worktechlabs/OpenPrinter/docs/inventario.md

# Inventario disponible (material reutilizado)

Material de impresoras 3D que ya hay en el taller y su uso previsto. Las listas
de compra lo cuentan a 0 €.

| Material | Cantidad | Uso en OpenDTF |
|---|---|---|
| BTT SKR Mini E3 V3.0 (STM32G0B1, 4 × TMC2209) | 1 | Placa de control con Klipper: motores X e Y, y dos drivers libres |
| Raspberry Pi 3 | 1 | Host de Klipper e interfaz web |
| Motor NEMA17 de 40 mm (Creality 42-40, Golden Motor 42HD4041-01) | varios | Motores X e Y; al Creality hay que quitarle el extrusor |
| Fuente de 24 V de impresora 3D | 1 | Fuente principal: motores, placa y ventiladores de 24 V |
| Fuente de 12 V | 1 | Reserva (ventiladores de 12 V si salen más baratos) |
| Perfil V-slot 2020 | por medir | Estructura de la cubierta (fase 6) |
| Kit de escuadras 2020 con tuercas | 10 juegos | Uniones de perfiles 2020 |
| Rodamientos 608ZZ (8 × 22 × 7) | ~20 | Poleas locas y apoyos del eje de levante (Ø8) |
| Ventiladores 4010 de 12 V | 6 | Refrigeración de la electrónica |
| Ruedas en V (POM) | por contar | Reserva: el carro va con guías MGN12 (más precisas) |
| Correas GT2 de 6 mm y poleas de 20 dientes | varias | Eje Y (correa cerrada aparte) y X en la fase 1 |

## Pendiente de confirmar

- Longitud de cada perfil 2020 y número de ruedas en V y tuercas excéntricas.
- Potencia de la fuente de 24 V (mirar la etiqueta): con 200 W o más sobra para
  la fase 1.
