worktechlabs/OpenPrinter/docs/fase1_movimiento.md

# Fase 1: movimiento

Objetivo: que la máquina se mueva como una impresora de verdad, todavía sin
cabezal. El carro barre el film a velocidad constante con su posición leída por
un encoder lineal, y el film avanza pasos precisos medidos por un encoder en el
rodillo.

**Hito**: 1000 pasadas seguidas a 0,6 m/s con el rizado de velocidad medido y
avances de film con error por debajo del 0,05 %, registrados desde la Raspberry Pi.

## Arquitectura

```mermaid
flowchart LR
    PI["Raspberry Pi 3+<br/>interfaz, cola de trabajos,<br/>Klipper (host), RIP"]
    CTRL["Placa de control<br/>BTT SKR Mini E3 V3.0 + Klipper"]
    MON["Monitor de encoder<br/>Raspberry Pi Pico (RP2040)"]
    HEAD["Placa de disparo del cabezal<br/>(fase 3)"]

    PI -- USB --> CTRL
    PI -- USB --> MON
    CTRL --> MX[Motor X]
    CTRL --> MY[Motor Y]
    PI -- GPIO --> PUMP["5 bombas de tinta<br/>módulo MOSFET"]
    FLOAT[5 flotadores de los subdepósitos] -- GPIO --> PI
    PI -- HDMI + USB --> LCD[Pantalla táctil de 7 pulgadas]
    CTRL --> FAN[4 ventiladores de vacío]
    HOME[Final de carrera X] --> CTRL
    PINCH[Interruptor de palanca de presión] --> CTRL
    FILMS[Sensor de film] --> CTRL
    ENCY["Encoder Y AS5047P<br/>en el rodillo"] -- SPI --> MON
    ENCX["Encoder X<br/>cinta 180 LPI + sensor óptico"] --> MON
    ENCX -.-> HEAD
    PI -. datos de pasada .-> HEAD
```

La idea clave es **separar el movimiento del disparo**:

- **Klipper** mueve los motores. Está probado, tiene *input shaping* y se
  configura con un archivo de texto. No necesita saber nada del cabezal.
- **El encoder X manda.** El cabezal no dispara según los pasos del motor, sino
  según la posición real que lee el encoder. Así, las irregularidades del motor
  o de la correa no se ven en la impresión.
- En la fase 1, el encoder X lo lee un **Raspberry Pi Pico** (con su PIO cuenta
  la cuadratura sin perder pulsos). Registra la posición y la velocidad de cada
  pasada para medir la calidad del movimiento. En la fase 3 ese mismo
  microcontrolador (o una FPGA) es la base de la placa de disparo.

## Componentes

**Se reutiliza material de impresora 3D.** La fase 1 está pensada para montarse
con lo que suele haber en un taller con impresoras 3D:

- **Raspberry Pi 3**: suficiente para Klipper y la interfaz web. Solo cuando
  llegue el RIP (fase 2) puede hacer falta una Pi 4 o 5 para procesar imágenes
  grandes.
- **Cualquier placa de impresora 3D compatible con Klipper** (SKR, MKS, Creality,
  Octopus…) con al menos 2 drivers: X e Y. Si no tiene 4 salidas de
  ventilador libres, los ventiladores de vacío se gobiernan con un módulo de
  MOSFET desde pines libres.
- **Motores NEMA17, correas y poleas GT2** de impresora 3D. La correa X está
  dibujada de 10 mm, pero una GT2 de 6 mm de fibra de vidrio vale para la fase 1;
  si a 0,6 m/s se nota elasticidad en las inversiones, se cambia por una de 9 o
  10 mm.

| Bloque | Elección | Por qué |
|---|---|---|
| Host | Raspberry Pi 3 o superior | Klipper, interfaz web y, más adelante, el RIP |
| Placa de control | BTT SKR Mini E3 V3.0 con Klipper (del inventario) | 4 drivers TMC2209: X, Y y dos libres; si más adelante faltan salidas, una Octopus da 8 drivers |
| Drivers | TMC2209 en UART, 24 V | Silenciosos y con corriente configurable; si el eje X se queda corto, TMC5160 |
| Motor X | NEMA17 de 40 mm (del inventario) | Ver cálculo abajo; uno de 48 mm da más margen |
| Motor Y | NEMA17 de 40 mm (del inventario) | Con la reducción 4:1 le sobra par |
| Pantalla | Táctil de 7" HDMI + USB con KlipperScreen | Mover ejes, cargar film, limpiar, rellenar tinta y lanzar trabajos sin ordenador |
| Tinta | 5 bombas peristálticas de 12 V y 5 subdepósitos con flotador | Relleno automático desde botellas de 1 L; GPIO de la Raspberry Pi como segunda MCU de Klipper |
| Encoder X | Cinta de 180 LPI + sensor óptico de cuadratura (tipo H9730) | Estándar en impresoras de inyección; se pueden sacar de impresoras rotas |
| Encoder Y | AS5047P magnético en el extremo del eje del rodillo | 14 bits: 5,8 µm de film por cuenta; lo lee el Pico por SPI |
| Final de carrera X | Sensor óptico de horquilla + bandera en el carro | Sin contacto y repetible; marca el *home* junto a la estación de servicio |
| Sensor de film | Reflexivo (TCRT5000) bajo la mesa de entrada | Detecta fin de rollo |
| Palanca de presión | Microinterruptor | Impide mover el eje Y con las ruedas levantadas |
| Alimentación | Fuente de 24 V de impresora 3D (del inventario) | Motores, ventiladores de 24 V y placa; con 200 W o más basta |
| 5 V | Convertidor 24 → 5 V de 5 A | Raspberry Pi y Pico |
| Seguridad | Seta de emergencia NC que corta los 24 V de los motores | Para el carro al instante |

## Números que justifican el diseño

**Velocidad del carro.** Un XP600 dispara a unos 8 kHz (dato a confirmar en la
fase 3). Con pasadas de 360 ppp, la velocidad máxima útil es
8000 / 360 = 22 pulgadas/s ≈ **0,56 m/s**. El objetivo es 0,6 m/s.

**Aceleración y margen.** A 10 m/s², alcanzar 0,6 m/s necesita
v² / 2a = **18 mm**. La zona de aceleración del modelo es de 60 mm a cada lado,
así que hay margen para acelerar más suave o subir la velocidad.

**Motor X.** El carro con cabezales, dampers y tinta pesa unos 1,2 kg. Para
acelerar a 10 m/s² hacen falta 12 N; con la polea de 20 dientes (radio
6,4 mm) son 0,08 N·m. A 0,6 m/s la polea gira a 900 rpm. Un NEMA17 de 40 mm
a 24 V da unos 0,12–0,15 N·m a esas vueltas: margen de 1,5 a 1,9 veces, justo
pero suficiente. Si en las pruebas pierde pasos, se baja la aceleración a
6 m/s² (necesita 30 mm de los 60 de margen) o se cambia por uno de 48 mm.

**Resolución X.** 180 líneas por pulgada con decodificación ×4 dan
720 cuentas por pulgada: **35 µm por cuenta**. La placa de disparo interpola
entre cuentas para colocar gotas a 720 ppp o más.

**Resolución Y.** Con la reducción 4:1 y el rodillo de Ø30, el motor avanza
23,6 mm por vuelta: 7,4 µm por micropaso a 1/16. El AS5047P mide 5,8 µm por
cuenta en el rodillo, que es lo que de verdad importa: la referencia es el
rodillo, no el motor.

## Señales en la placa de control

La configuración de Klipper que usa estas señales está en
[firmware/](../firmware/README.md).

Necesidades mínimas: 2 drivers, 3 entradas digitales y salidas para los
ventiladores. La placa elegida es la **BTT SKR Mini E3 V3.0** del
inventario (ver [inventario.md](inventario.md)): 4 drivers TMC2209 en UART, y
las salidas de calentador sirven como interruptores de 24 V para los
ventiladores de vacío.

| Señal | Tipo | Conector SKR Mini E3 V3.0 |
|---|---|---|
| Motor X | paso/dirección + UART | X |
| Motor Y | paso/dirección + UART | Y |
| (libre) | paso/dirección + UART | Z |
| (libre: circulación del blanco, fase 4) | paso/dirección + UART | E |
| Final de carrera X | entrada digital | X-STOP |
| Interruptor de palanca de presión | entrada digital | Y-STOP |
| Sensor de film | entrada digital | E0-STOP (la entrada de fin de filamento) |
| Ventiladores de vacío centrales (2) | 24 V conmutado | HE0 |
| Ventiladores de vacío laterales (2) | 24 V conmutado | HB |
| Ventilador de la electrónica | PWM | FAN0 |

- Los ventiladores de vacío van en dos grupos: los dos centrales se encienden
  con cualquier ancho de film y los dos laterales solo con film de 60 cm.
- **El encoder Y (AS5047P) va al Raspberry Pi Pico por SPI**, junto con el
  encoder X: así todas las medidas de posición están en el mismo
  microcontrolador y la SKR no necesita SPI libre.
- Los ventiladores 4010 del inventario son de 12 V. Para enfriar la
  electrónica, aliméntalos desde la fuente de 12 V o con un convertidor
  24 → 12 V; o usa uno de 24 V en FAN0.

La asignación definitiva de pines se hará con el `printer.cfg` de Klipper,
comprobando el esquema oficial de la placa.

## Cómo va colocado

- **Cinta del encoder X**: a lo largo de la cara delantera de la viga, entre las
  dos guías. Va sujeta en los extremos con soportes impresos, uno de ellos con
  muelle para tensarla. El sensor va en la cara trasera de la placa del carro,
  entre los patines.
- **Final de carrera X**: sobre el soporte de la polea loca, a la derecha. La
  bandera es una aleta impresa en la parte alta del carro.
- **Encoder Y**: el eje del rodillo sale 13 mm por fuera de la placa izquierda.
  Lleva un imán diametral en la punta, y la placa del AS5047P va en un soporte
  impreso atornillado a la placa lateral.
- **Cadena portacables X**: en una bandeja impresa detrás de la viga. Va
  anclada en el centro del recorrido y sube hasta un brazo impreso que sale de
  la pinza de correa del carro, por encima de la viga.
- **Electrónica** (`cad/wiring.py`): bandeja de MDF de 10 mm de lado a lado
  bajo la mesa de vacío, apoyada en los dos largueros laterales y en el
  travesaño central.
  - A la izquierda, una **caja impresa** con la SKR Mini E3 V3.0, la Raspberry
    Pi 3, el Pico y los convertidores a 5 V y 12 V, con dos ventiladores 4010 en
    la tapa y rejilla en el frente.
  - A la derecha, la **fuente de 24 V**, sujeta con dos bridas impresas. Sus
    medidas están en `PSU_SIZE` (215 × 115 × 50 mm de referencia): mide la tuya.
- **Paneles**: entrada de red IEC C14 con interruptor y fusible en el larguero
  trasero, y seta de emergencia en el larguero delantero.
- **Cables ocultos**:
  - Canaleta impresa con tapa por el borde trasero de la bandeja, sobre los
    largueros laterales y por la cara interior de las placas.
  - Por la izquierda suben hasta la bandeja de la cadena portacables (carro,
    motor X, tubos de tinta) y hasta el encoder Y; por la derecha, hasta el
    motor Y. Las placas llevan sus pasos de cable.
  - Los cables sueltos de sensores (final de carrera, palanca de presión) van
    por las ranuras de los perfiles con tapa de ranura.
- **Pantalla** (`cad/wiring.py`): táctil de 7" en una carcasa impresa en la
  esquina delantera derecha, inclinada 20°, con una pletina atornillada a la
  cara interior de la placa derecha. El HDMI y el USB bajan por una canaleta
  vertical hasta la canaleta del larguero.
- **Tinta a granel** (`cad/ink.py`):
  - **Botellas**: 5 botellas de 1 L en una caja de plástico comprada (bandeja
    antiderrames) con una base impresa, sobre una repisa de MDF de 12 mm detrás
    de la máquina, a la derecha. La repisa se atornilla al larguero trasero y
    apoya en la mesa con una pata. Queda fuera del ancho del rollo, para
    cargarlo desde atrás.
  - **Bombas**: 5 peristálticas de 12 V en un soporte impreso por fuera de la
    placa izquierda, detrás, junto a la caja del módulo MOSFET.
  - **Subdepósitos**: encima de las bombas, 5 subdepósitos con flotador a
    altura fija, con el nivel unos 40 mm por debajo de las boquillas.
  - **Tubos**: suben pegados a la placa con clips y entran por el agujero
    trasero a la bandeja de la cadena portacables.
  - **Control**: Klipper usa la Raspberry Pi como segunda MCU (`[mcu host]`).
    Cada bomba es un `output_pin` y cada flotador un `gcode_button`. Una macro
    rellena hasta que el flotador sube, con un tiempo máximo, y si se pasa avisa
    de que esa botella está vacía.

| | |
|---|---|
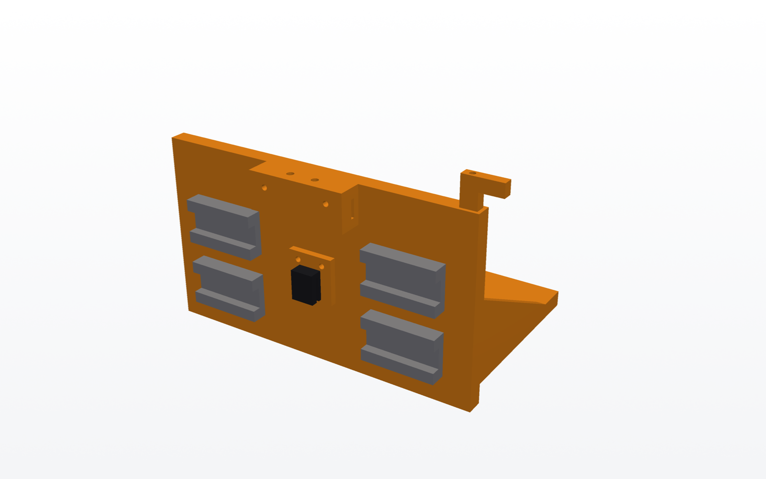
[picture p14: docs/img/carro_trasera.png]
Carro por detrás
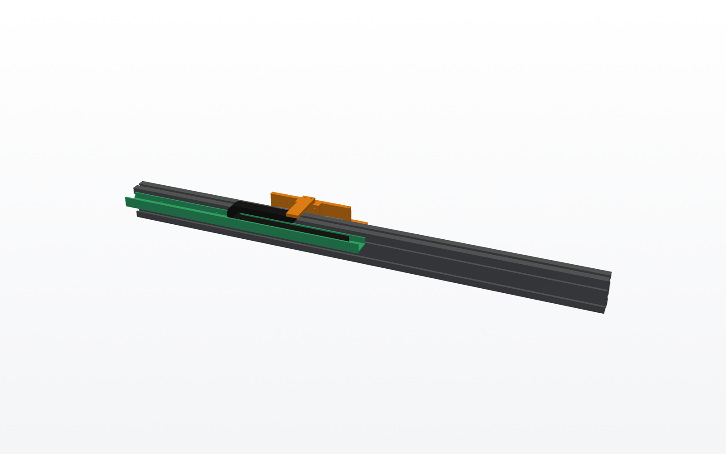
[picture p15: docs/img/cadena.png]
Cadena portacables
|  |  |
| Sensor del encoder X entre los patines y bandera del final de carrera | Cadena portacables en su bandeja detrás de la viga |
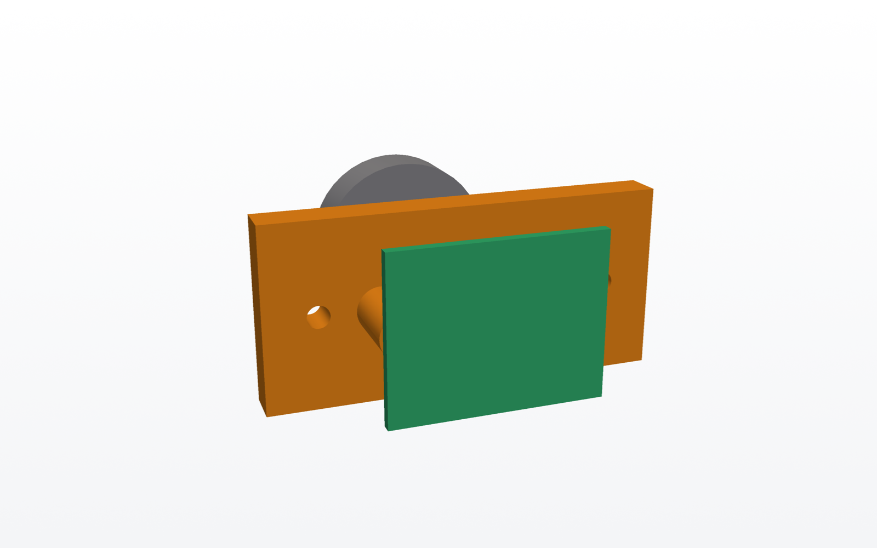
[picture p16: docs/img/encoder_y.png]
Encoder Y
|  | Electrónica |
| Encoder Y: AS5047P frente al imán en la punta del eje del rodillo | Caja de electrónica y fuente de 24 V sobre la bandeja inferior |
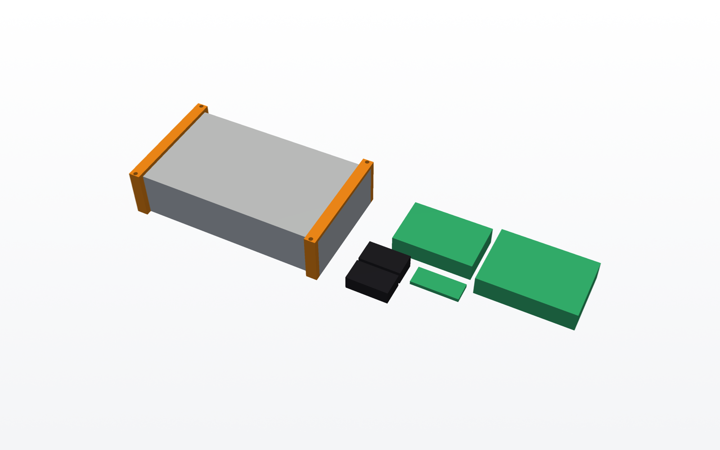
[picture p17: docs/img/electronica_interior.png]
Dentro de la caja
|  | Canaletas |
| SKR Mini E3 V3.0, Raspberry Pi 3, Pico y convertidores | Canaletas, paneles de red y emergencia, cadena y compartimento de tinta |
| Botellas | Bombas y subdepósitos |
| Botellas de 1 L en su caja sobre la repisa trasera | Bombas peristálticas y subdepósitos con flotador |
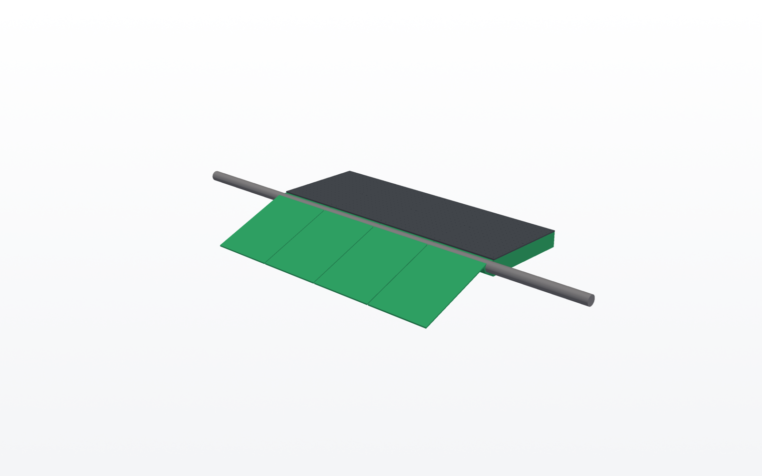
[picture p18: docs/img/salida.png]
Salida
| Pantalla |  |
| Pantalla táctil en su carcasa | Rampa de salida del film en la guía delantera |

Piezas impresas de esta fase (STL en `out/stl/`): soportes del encoder X, final
de carrera, soporte del encoder Y, bandeja y brazo de la cadena, caja de
electrónica, bridas de la fuente, paneles IEC y de emergencia, canaletas,
repisa, base de botellas, soportes de bombas y subdepósitos, caja del driver,
clips de los tubos y carcasa de la pantalla. Unos 2 kg de filamento; las
cantidades exactas están en [compra_fase1.md](compra_fase1.md).

## Pruebas de la fase 1

El Pico con [`firmware/pico_encoder`](../firmware/README.md#monitor-de-encoders-raspberry-pi-pico)
registra los encoders y `registro.py` calcula los resultados de las pruebas 1 y 2.

1. **Movimiento X**: 1000 pasadas a 0,6 m/s. El Pico registra la velocidad en
   la zona central; se busca un rizado por debajo del 1 % y que la posición de
   cada inversión se repita en ±1 cuenta.
2. **Avance Y**: 100 avances de 6,35 mm comparando lo que ordena Klipper, lo
   que mide el AS5047P y unas marcas en el film medidas con calibre. Objetivo:
   error acumulado por debajo del 0,05 %.
3. **Arrastre recto**: 2 m de film sin que se desvíe más de 1 mm de lado.
4. **Vacío**: el film queda plano en las 4 zonas, y apagando las de los lados
   con film estrecho.
5. **Seguridad**: la seta para los motores en cualquier punto del recorrido.

## Fuera de esta fase

- El cabezal, la placa de disparo y el RIP (fases 2 y 3).
- No hay rollo de recogida: el film impreso cae por delante hasta que llegue la
  agitadora de polvo con horno (fase 5), que tiene su propia recogida.
