worktechlabs/OpenPrinter/docs/plantillas/placa_lateral_A4.pdf

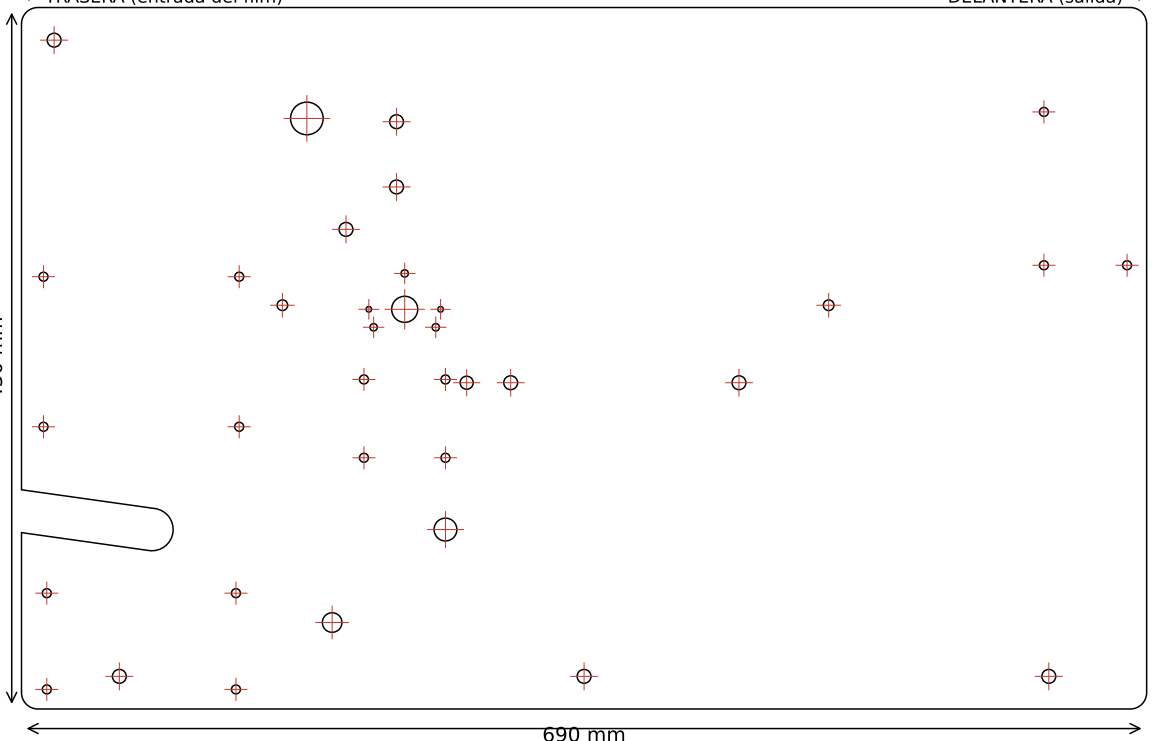
[picture p19: figure]

690 mm

430 mm

← TRASERA (entrada del film) | DELANTERA (salida) →

# OpenDTF · placa lateral (x2, MDF 19 mm)

# Instrucciones

1. Imprime al 100 % (tamaño real). Mide la regla de 100 mm de cada hoja.
2. Empalma las hojas por la cuadrícula y pégalas con cinta.

### 3. Pega la plantilla sobre un tablero de MDF de 19 mm. Pon debajo el segundo tablero, sujeta los dos con sargentos y córtalos juntos:

las dos placas laterales son iguales y saldrán idénticas.
4. Contorno y ranuras de los rollos: caladora con hoja para madera, por fuera de la línea. Lija hasta la línea.

### 5. Taladros: granetea las cruces rojas, pasa broca de 3 mm por los

dos tableros y luego abre a la medida indicada.

### 6. Ranuras: taladra Ø26 en el fondo (asiento del eje) y corta las

dos rectas con la caladora.
7. Sella los cantos con cola diluida o barniz para que no se deshilachen.

### Los rodamientos del rodillo NO van en el MDF: van en el alojamiento

impreso (rodillo_alojamiento_6001.stl), por dentro, con 3 tornillos M4.

### Son 8 hojas: 2 filas x 4 columnas, con 10 mm

de solape. Empálmalas haciendo coincidir la cuadrícula de 50 mm.

# Taladros (desde la esquina trasera-inferior)

Ø3.4 (M3) | Y= 213.0 Z= 245.0
Ø4.5 (M4) | Y= 235.0 Z= 267.0
Ø5.5 (M5) | Y= 13.5 Z= 265.0
Ø5.5 (M5) | Y= 131.5 Z= 12.0
Ø5.5 (M5) | Y= 133.5 Z= 265.0
Ø5.5 (M5) | Y= 260.0 Z= 154.0
Ø5.5 (M5) | Y= 627.0 Z= 366.0
Ø6.5 (M6) | Y= 495.0 Z= 247.5
Ø8.5 (M8) | Y= 60.0 Z= 20.0
Ø8.5 (M8) | Y= 230.0 Z= 360.0
Ø8.5 (M8) | Y= 440.0 Z= 200.0
Ø14 | Y= 260.0 Z= 110.0
Ø3.4 (M3) | Y= 257.0 Z= 245.0
Ø4.5 (M4) | Y= 254.1 Z= 234.0
Ø5.5 (M5) | Y= 15.5 Z= 12.0
Ø5.5 (M5) | Y= 131.5 Z= 71.0
Ø5.5 (M5) | Y= 210.0 Z= 154.0
Ø5.5 (M5) | Y= 260.0 Z= 202.0
Ø5.5 (M5) | Y= 678.0 Z= 272.0
Ø8 | Y= 273.0 Z= 200.0
Ø8.5 (M8) | Y= 199.0 Z= 294.0
Ø8.5 (M8) | Y= 300.0 Z= 200.0
Ø8.5 (M8) | Y= 630.0 Z= 20.0
Ø16 (eje Ø12) | Y= 235.0 Z= 245.0
Ø4.5 (M4) | Y= 215.9 Z= 234.0
Ø5.5 (M5) | Y= 13.5 Z= 173.0
Ø5.5 (M5) | Y= 15.5 Z= 71.0
Ø5.5 (M5) | Y= 133.5 Z= 173.0
Ø5.5 (M5) | Y= 210.0 Z= 202.0
Ø5.5 (M5) | Y= 627.0 Z= 272.0
Ø6.5 (M6) | Y= 160.0 Z= 247.5
Ø8.5 (M8) | Y= 20.0 Z= 410.0
Ø8.5 (M8) | Y= 230.0 Z= 320.0
Ø8.5 (M8) | Y= 345.0 Z= 20.0
Ø12 | Y= 190.5 Z= 53.0
Ø20 (tubos) | Y= 175.0 Z= 362.0

100 mm: compruébalo con una regla

### OpenDTF · placa lateral (x2, MDF 19 mm) · hoja fila 1 / columna 1

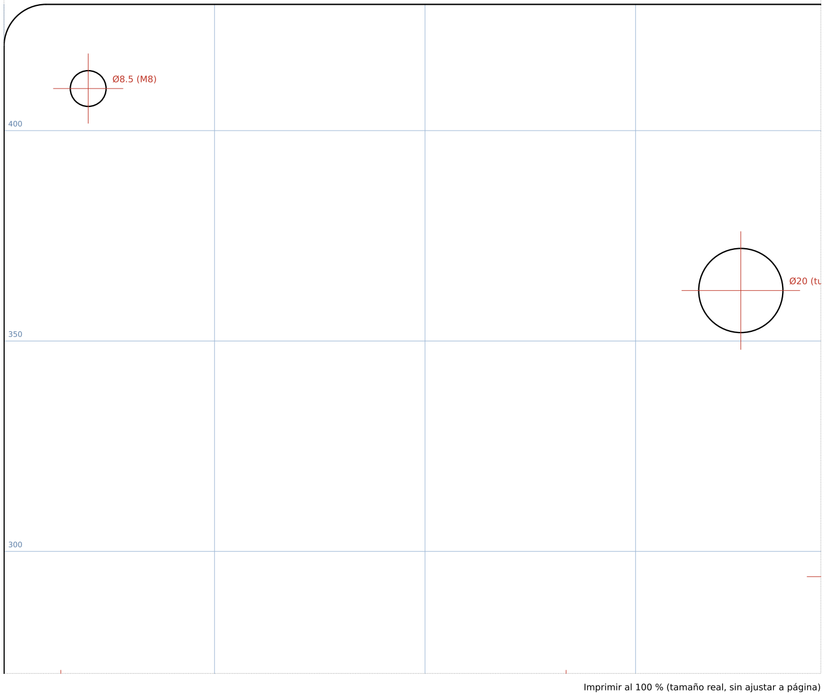
[picture p20: figure]
Ø20 (tubos)

Imprimir al 100 % (tamaño real, sin ajustar a página)

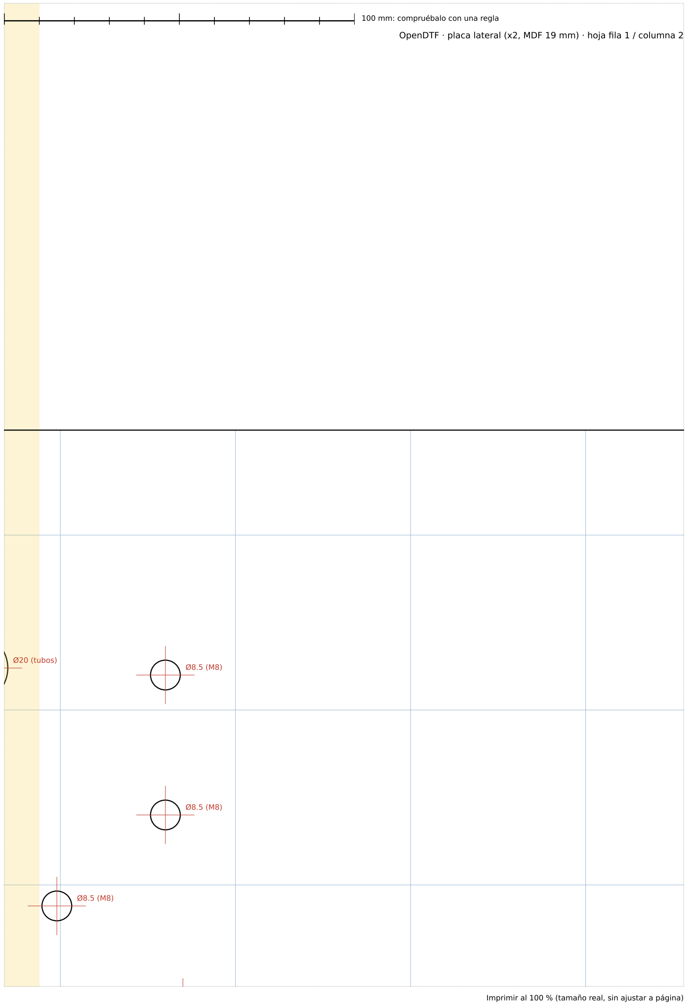
[picture p21: figure]
Ø20 (tubos)

### OpenDTF · placa lateral (x2, MDF 19 mm) · hoja fila 1 / columna 2

### OpenDTF · placa lateral (x2, MDF 19 mm) · hoja fila 1 / columna 3

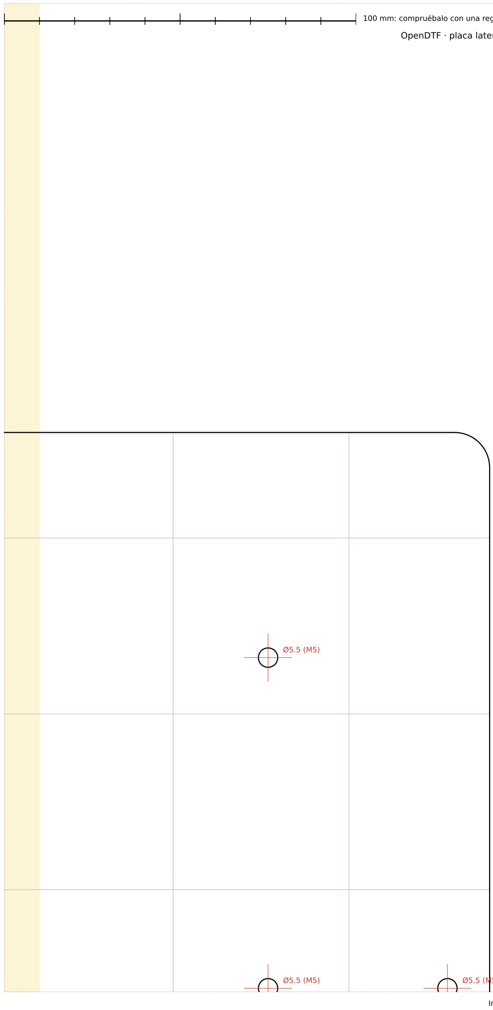
[picture p22: figure]

### OpenDTF · placa lateral (x2, MDF 19 mm) · hoja fila 1 / columna 4

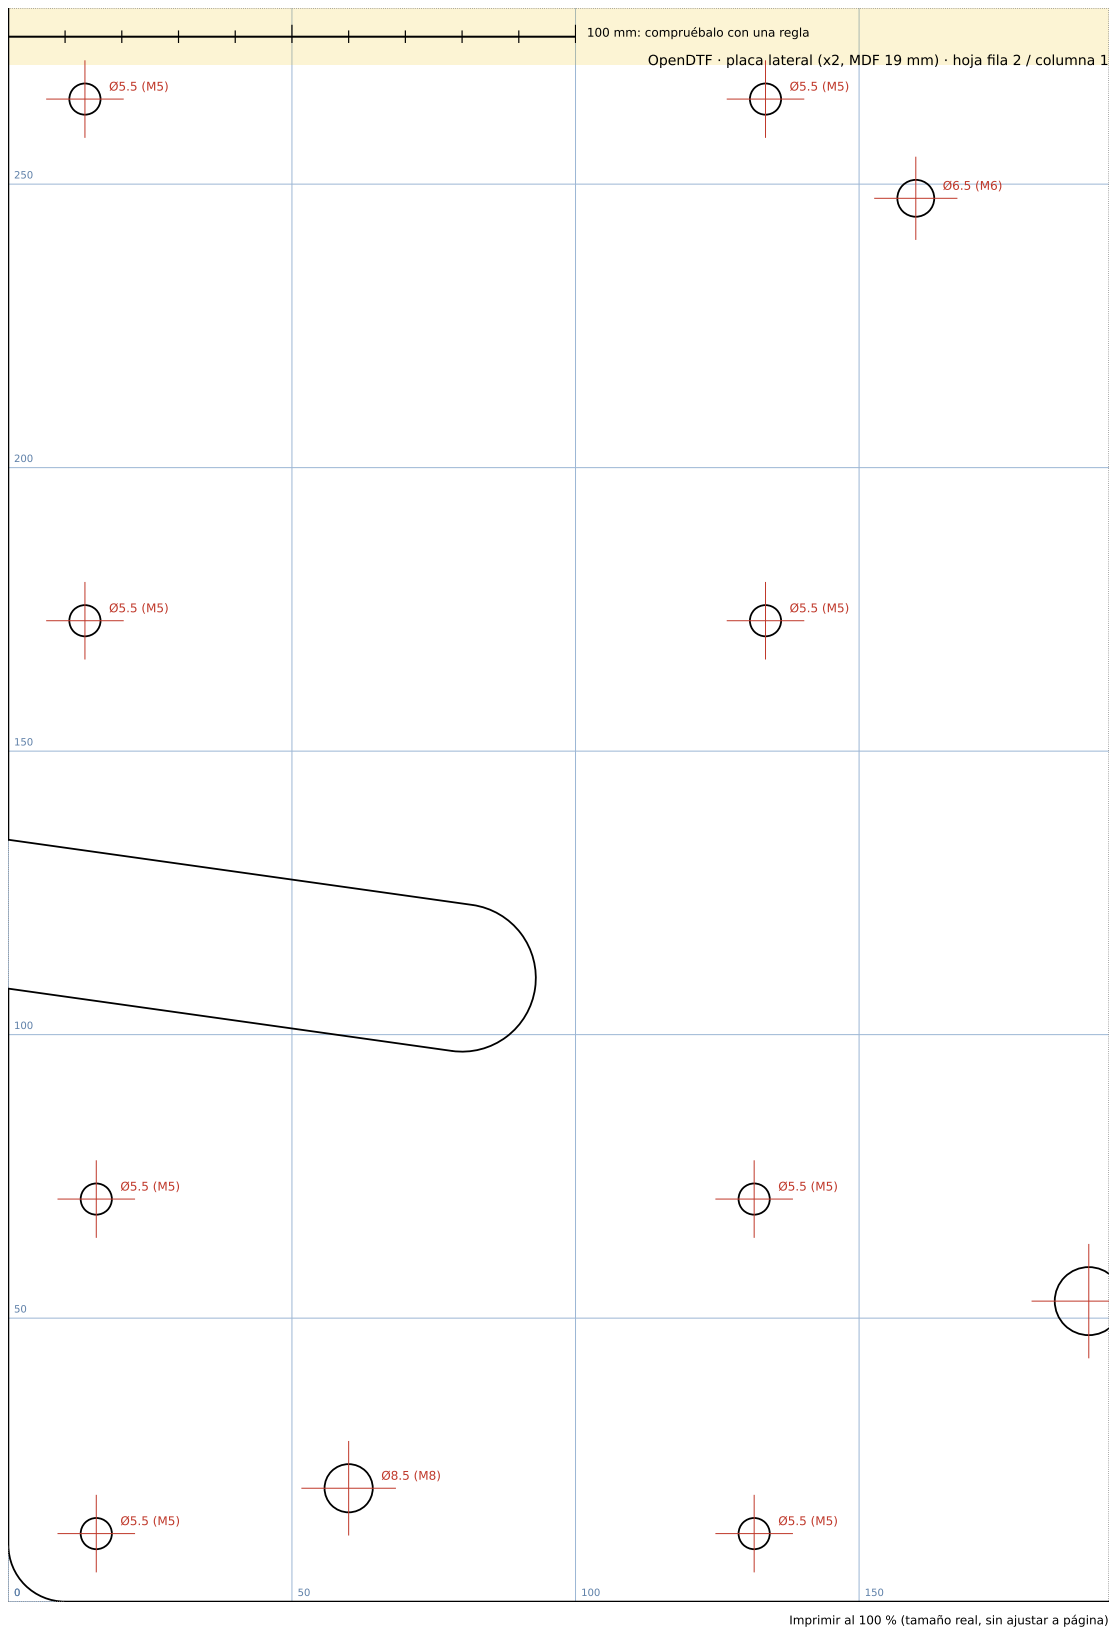
[picture p23: page 6]
OpenDTF · placa; lateral (x2, MDF 19 mm) · hoja fila 2 / columna 1

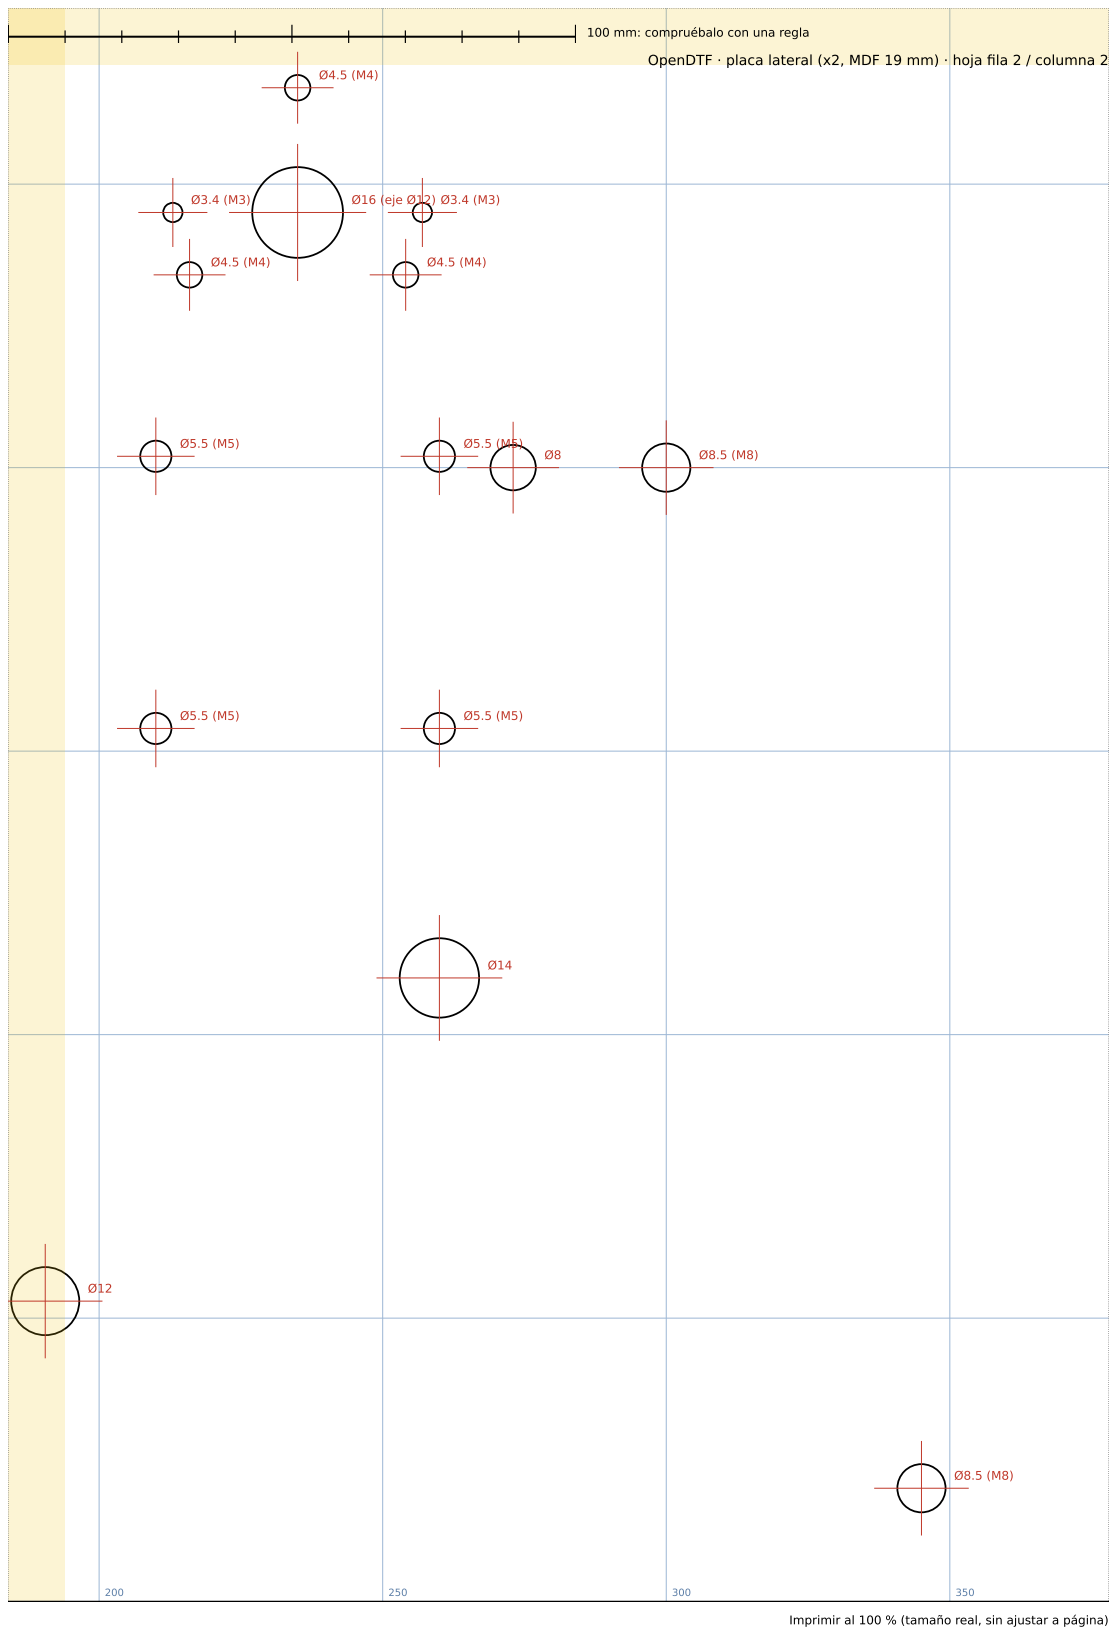
[picture p24: page 7]
Ø16 (eje Ø12) Ø3.4 (M3); OpenDTF · placa lateral (x2, MDF 19 mm) ·; hoja fila 2 / columna 2

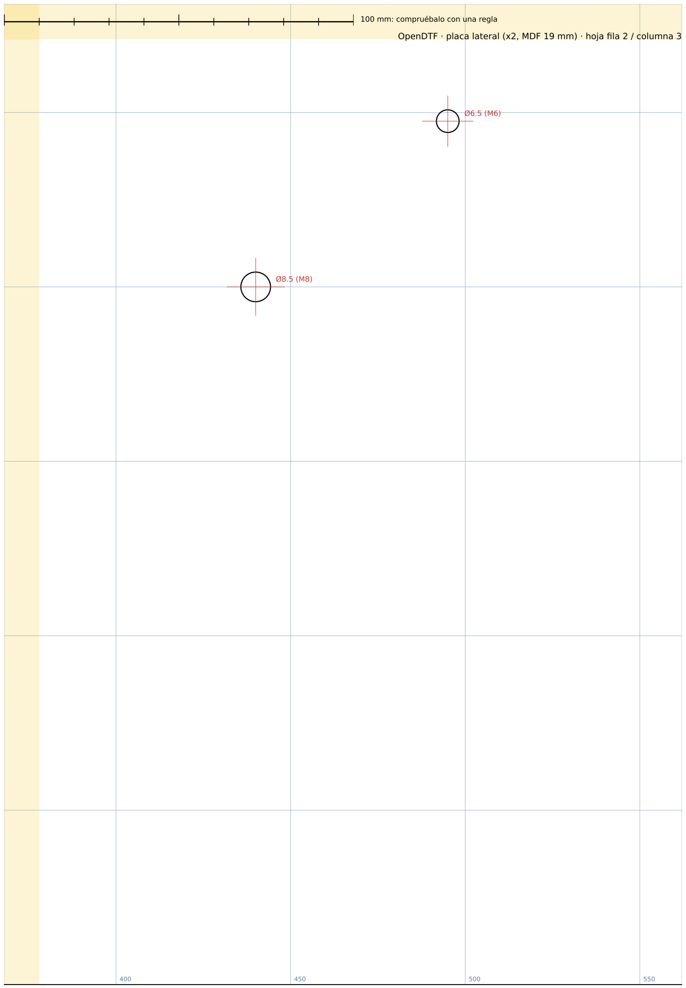
[picture p25: figure]

### OpenDTF · placa lateral (x2, MDF 19 mm) · hoja fila 2 / columna 3

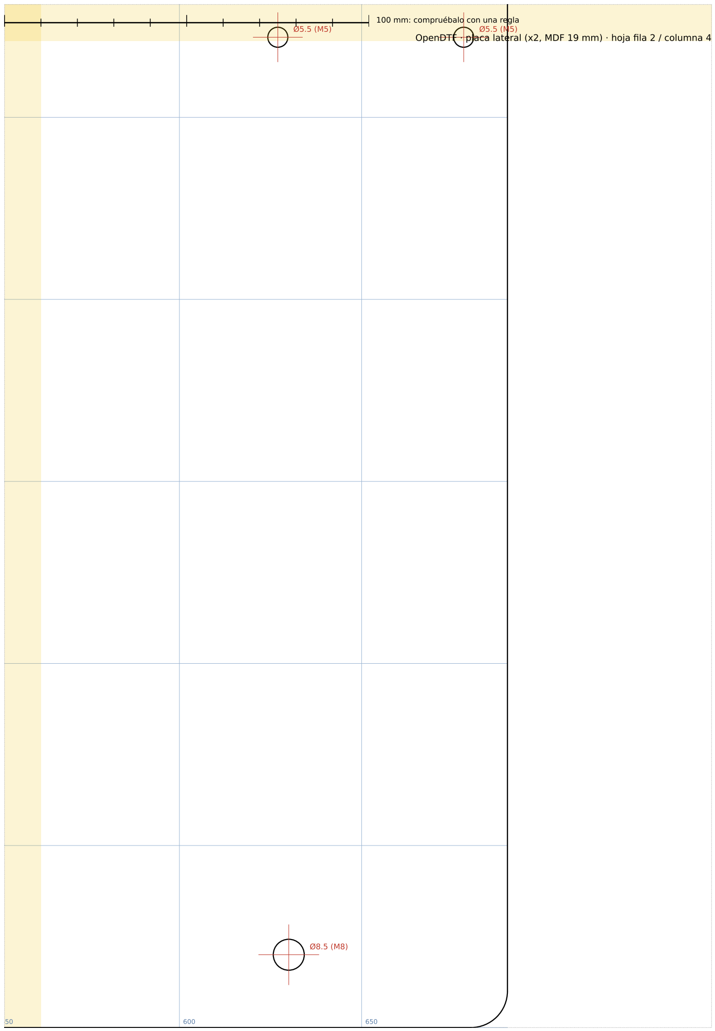
[picture p26: figure]

### OpenDTF · placa lateral (x2, MDF 19 mm) · hoja fila 2 / columna 4
