worktechlabs/OpenPrinter/docs/img/general_izquierda.png

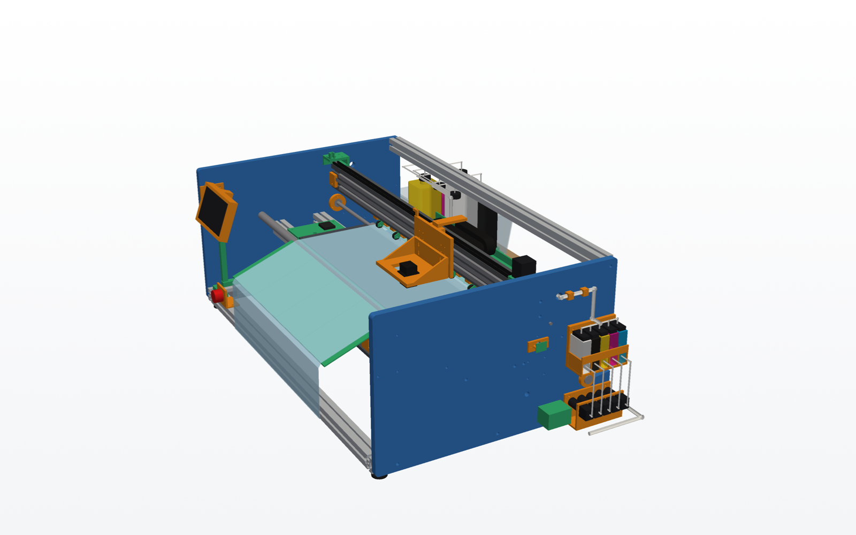
docs/img/general_izquierda.png
