worktechlabs/OpenPrinter/docs/img/mandril.png

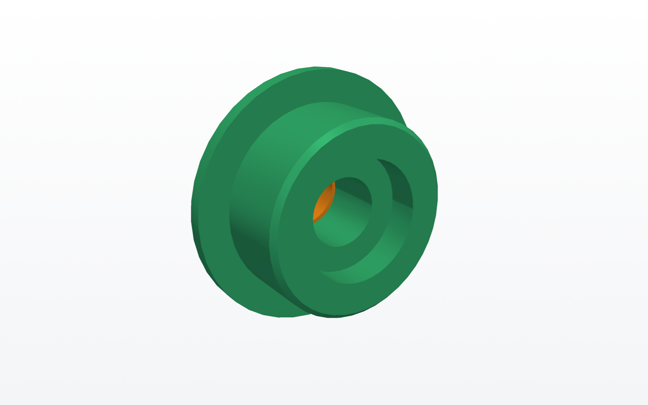
docs/img/mandril.png
