worktechlabs/OpenPrinter/docs/img/mesa_camara.png

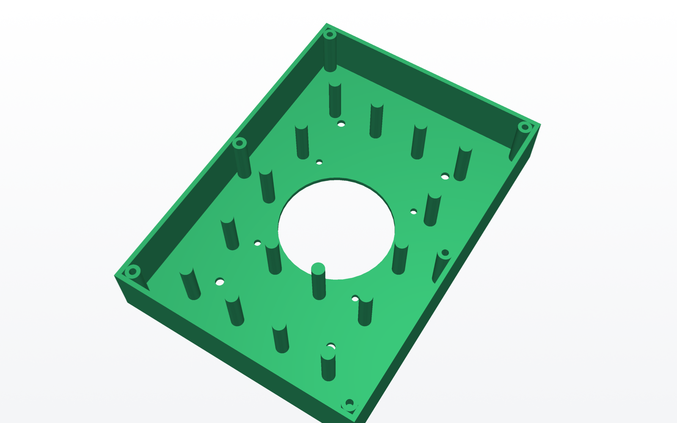
docs/img/mesa_camara.png
