worktechlabs/OpenPrinter/docs/compra_fase1.csv

categoria | articulo | especificacion | cantidad | precio_unitario_eur | notas
Control | BTT SKR Mini E3 V3.0 | 4 x TMC2209, Klipper | 1 | 0 | del inventario
Control | Raspberry Pi 3 o superior | con tarjeta microSD de 16 GB | 1 | 0 | ya disponible
Control | Raspberry Pi Pico | RP2040 | 1 | 5 | monitor del encoder X
Motores | Motor NEMA17 | 40 mm | 2 | 0 | X e Y | del inventario (Creality 42-40, 42HD4041)
Sensores | Cinta de encoder 180 LPI | 1200 mm | 1 | 15 | recambio de plóter de gran formato, o de impresoras rotas
Sensores | Resistencias 10 kΩ y 20 kΩ | divisor 5 V a 3,3 V | 2 | 0.1 | canales A y B del encoder X hacia el Pico, si el sensor es de 5 V
Sensores | Sensor de encoder de cuadratura | tipo H9730/H9740, 180 LPI | 1 | 6 | o sacado de una impresora rota
Sensores | Placa AS5047P + imán diametral | imán 6 x 2,5 mm | 1 | 15 | encoder Y
Sensores | Sensor óptico de horquilla | tipo TCST2103, módulo | 1 | 2 | final de carrera X
Sensores | Sensor reflexivo TCRT5000 | módulo | 1 | 1 | detección de film
Sensores | Microinterruptor | con palanca | 1 | 1 | palanca de presión
Cableado | Cadena portacables | 10 x 20 mm, 600 mm | 1 | 8
Cableado | Cable apantallado 4 hilos | 2 m | 2 | 2 | encoders
Cableado | Alargadores de motor y conectores JST |  | 1 | 10
Alimentación | Fuente 24 V | de impresora 3D, 200 W o más | 1 | 0 | del inventario
Alimentación | Convertidor 24 V a 5 V | 5 A | 1 | 8 | Raspberry Pi y Pico
Alimentación | Seta de emergencia NC | 22 mm, con caja | 1 | 8 | corta los 24 V de los motores
Alimentación | Conector IEC con interruptor y fusible |  | 1 | 5
Montaje | Bandeja inferior de electrónica | MDF 10 mm, 1100 x 160 mm | 1 | 4 | apoya en los largueros laterales y el central
Montaje | Convertidor 24 V a 12 V | 5 A | 1 | 6 | ventiladores 4010 y bombas de tinta
Montaje | Tapa de ranura 8 mm | 2 m | 1 | 6 | cables de sensores por las ranuras de la viga
Montaje | Bridas y portabridas adhesivos |  | 1 | 4
Montaje | Separadores M3 de nylon | 6 mm | 16 | 0.1
Montaje | Tuerca en T M5 + tornillo M5 |  | 11 | 0.3 | placa de electrónica y bandeja
Montaje | Inserto térmico M3 + tornillo M3 |  | 12 | 0.15 | soportes de sensores y brazo
Pantalla | Pantalla táctil 7" HDMI + USB | 1024 x 600, KlipperScreen | 1 | 35 | medir la que se compre y ajustar SCREEN_SIZE
Pantalla | Cable HDMI fino + USB | 1,5 m | 1 | 6 | por las canaletas hasta la Raspberry Pi
Tinta | Caja de plástico con tapa | 395 x 255 x 155 mm o mayor | 1 | 9 | tipo Really Useful Box 9 L | bandeja antiderrames de las botellas
Tinta | Repisa | MDF 12 mm, 420 x 300 mm | 1 | 3
Tinta | Tapón de botella con 2 racores | salida de tubo + respiradero | 5 | 3 | para las botellas de 1 L del fabricante
Tinta | Filtro de aire para respiradero |  | 5 | 1
Tinta | Bomba peristáltica 12 V | tubo de silicona 2 x 4 mm | 5 | 7 | rellena los subdepósitos | parada, cierra el tubo
Tinta | Subdepósito de tinta con sensor de nivel | ~100 ml, flotador | 5 | 6 | recambio de DTF/UV, o depósito + interruptor de flotador
Tinta | Módulo MOSFET 4 + 1 canales o placa ULN2803 | entrada 3,3 V | 1 | 6 | bombas desde los GPIO de la Raspberry Pi
Tinta | Agitador magnético mini + imán |  | 1 | 12 | bajo la botella de blanco
Tinta | Tubo de tinta 3 x 2 mm | 10 m | 1 | 10 | botella, bomba, subdepósito y carro
Tinta | Racores y uniones para tubo de 3 mm |  | 1 | 5
Tinta | Resistencias 10 kΩ + diodos 1N4007 |  | 5 | 0.2 | pull-up de los flotadores y diodo de cada bomba (firmware/README.md)
