worktechlabs/OpenPrinter/docs/model/tinta_completo.stl

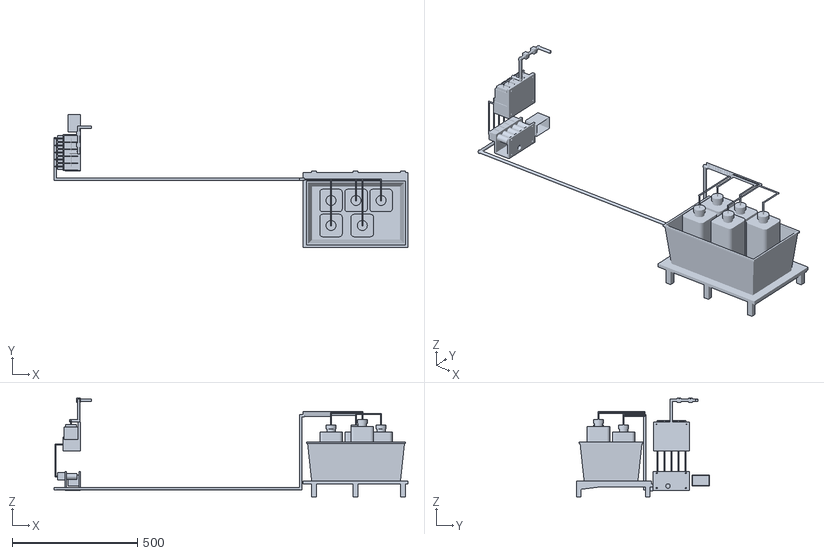
[picture p30: CAD file, 2026-10-31]
docs/model/tinta_completo.stl
1414.0 x 530.5 x 394.0
