worktechlabs/OpenPrinter/docs/stl/tinta_pata_repisa.stl

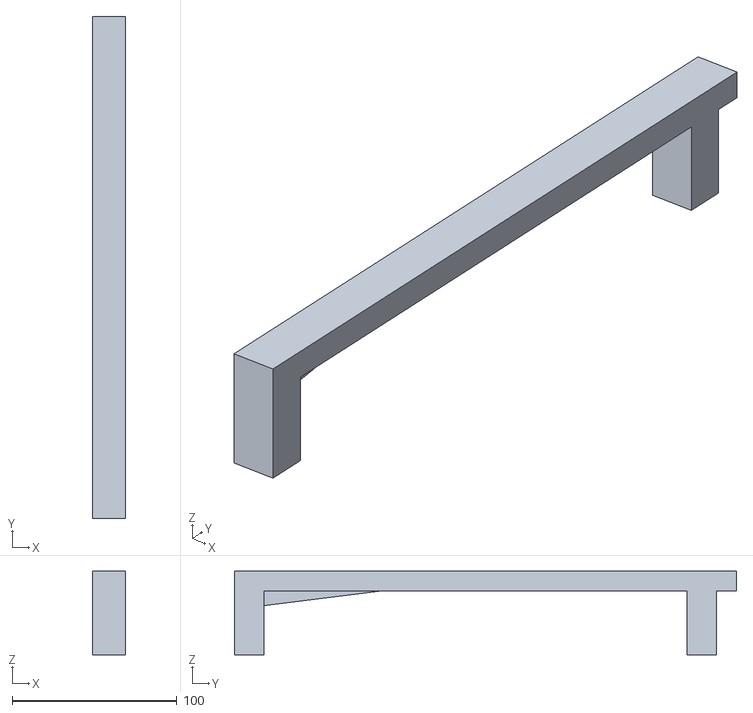
[picture p31: CAD file, 2026-10-31]
docs/stl/tinta_pata_repisa.stl
20.0 x 305.0 x 51.0
