worktechlabs/OpenPrinter/docs/model/opendtf_completo.stl

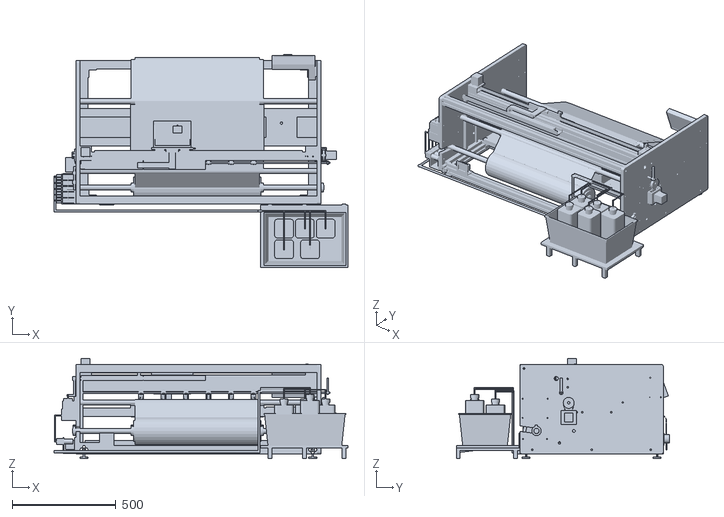
[picture p32: CAD file, 2026-10-31]
docs/model/opendtf_completo.stl
1414.0 x 1025.0 x 482.0
