worktechlabs/OpenPrinter/docs/stl/presion_leva.stl

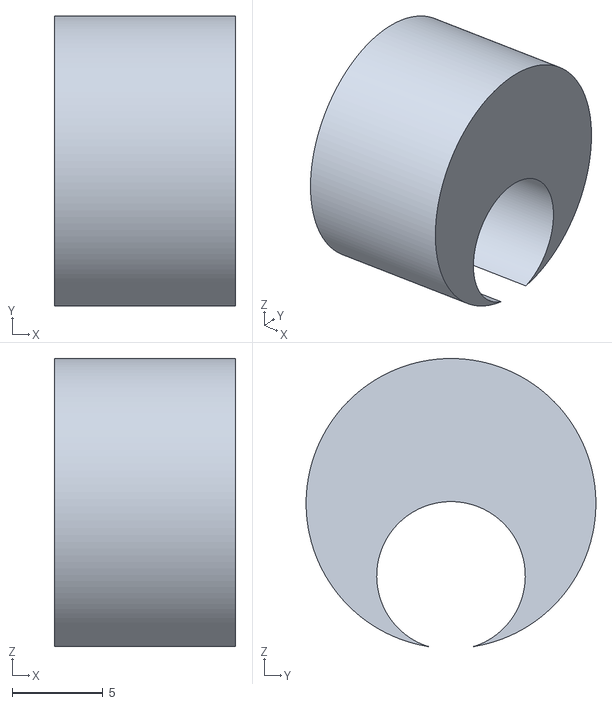
[picture p33: CAD file, 2026-10-31]
docs/stl/presion_leva.stl
10.0 x 16.0 x 15.9
