worktechlabs/OpenPrinter/docs/stl/panel_iec.stl

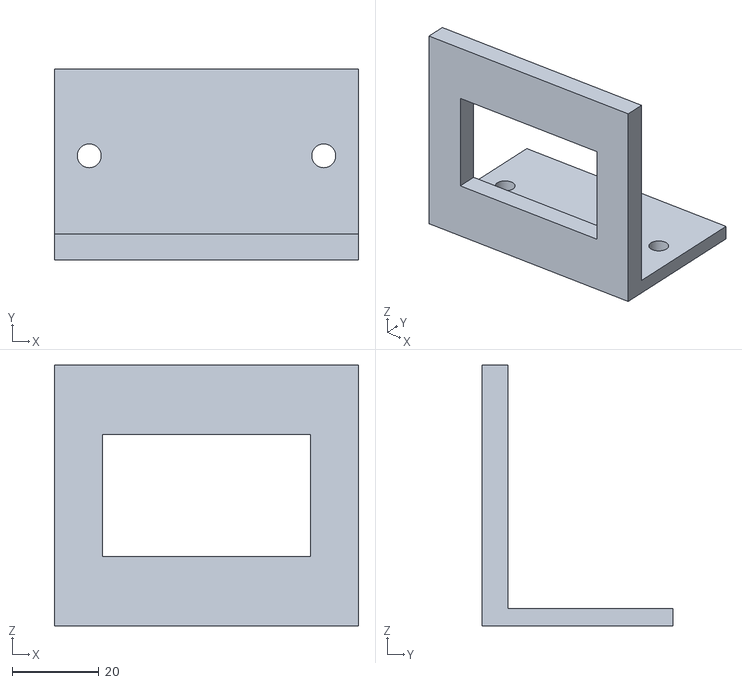
[picture p34: CAD file, 2026-10-31]
docs/stl/panel_iec.stl
70.0 x 44.0 x 60.0
