worktechlabs/OpenPrinter/docs/stl/carro_placa.stl

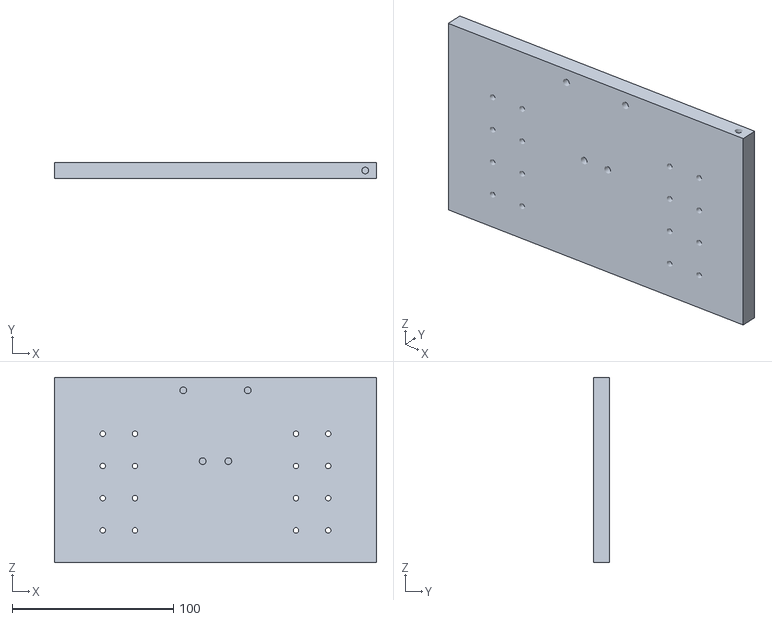
[picture p35: CAD file, 2026-10-31]
docs/stl/carro_placa.stl
200.0 x 10.0 x 115.0
