worktechlabs/OpenPrinter/docs/stl/rollo_mandril.stl

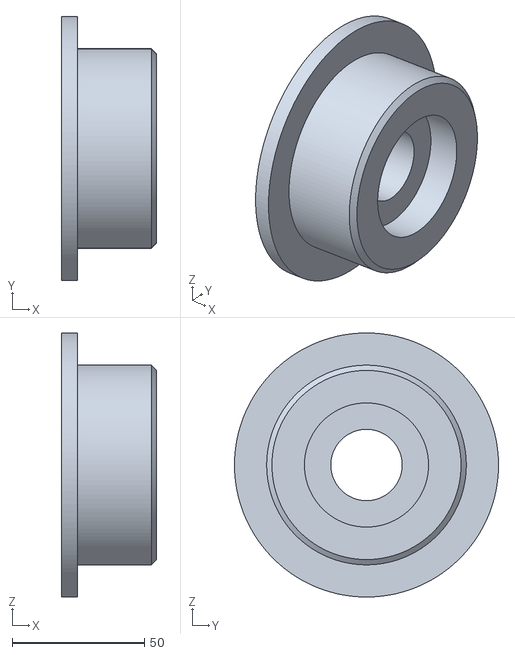
[picture p36: CAD file, 2026-10-31]
docs/stl/rollo_mandril.stl
36.0 x 100.0 x 100.0
