worktechlabs/OpenPrinter/docs/stl/presion_rueda_tpu.stl

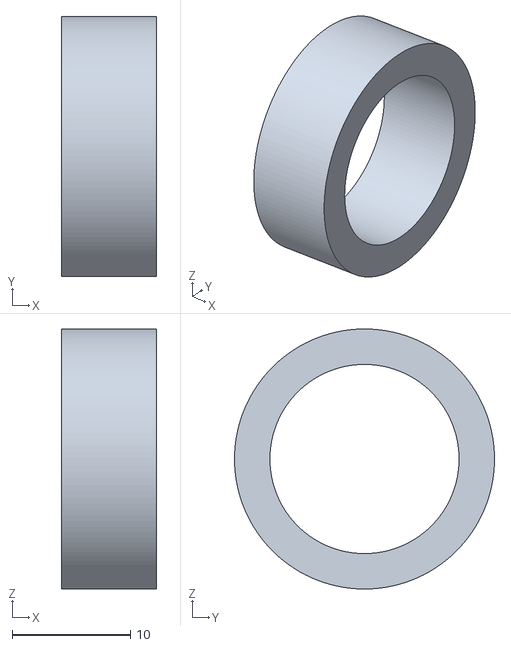
[picture p37: CAD file, 2026-10-31]
docs/stl/presion_rueda_tpu.stl
8.00 x 22.0 x 22.0
