worktechlabs/OpenPrinter/docs/stl/cadena_brazo.stl

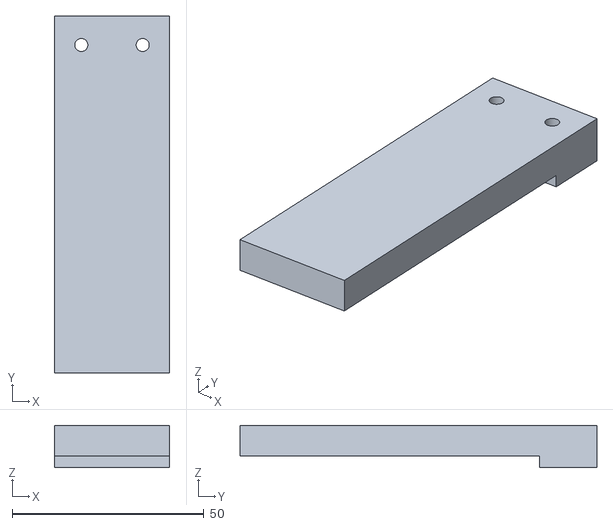
[picture p38: CAD file, 2026-10-31]
docs/stl/cadena_brazo.stl
30.0 x 93.0 x 11.0
