worktechlabs/OpenPrinter/docs/stl/rodillo_alojamiento_6001.stl

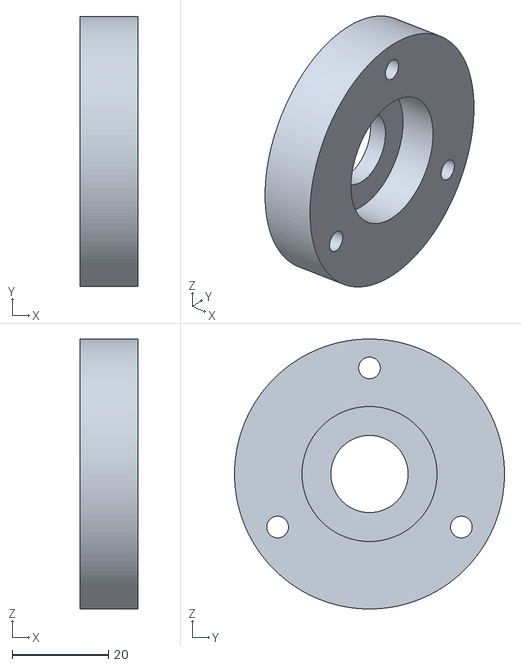
[picture p39: CAD file, 2026-10-31]
docs/stl/rodillo_alojamiento_6001.stl
12.0 x 56.0 x 56.0
