worktechlabs/OpenPrinter/docs/stl/carro_pinza_correa.stl

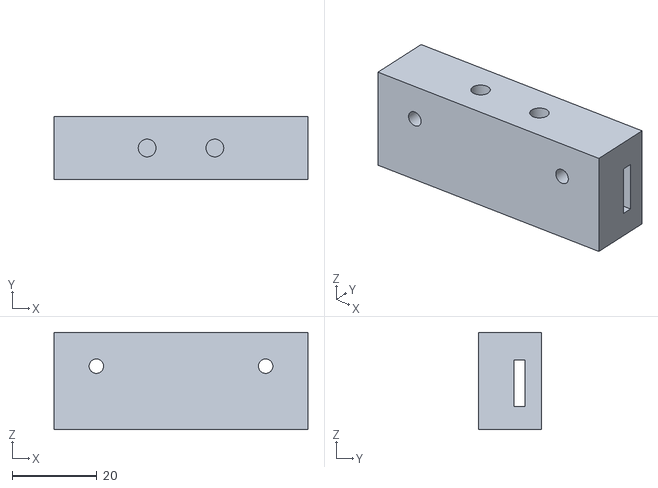
[picture p40: CAD file, 2026-10-31]
docs/stl/carro_pinza_correa.stl
60.0 x 15.0 x 23.0
