worktechlabs/OpenPrinter/docs/stl/mesa_salida_segmento.stl

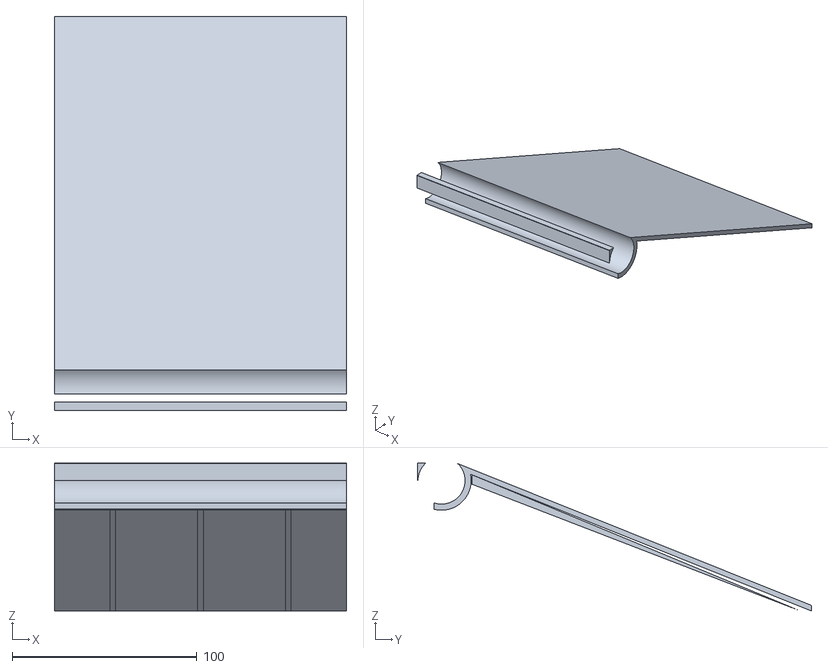
[picture p41: CAD file, 2026-10-31]
docs/stl/mesa_salida_segmento.stl
158.0 x 213.0 x 80.0
