worktechlabs/OpenPrinter/docs/stl/presion_brazo.stl

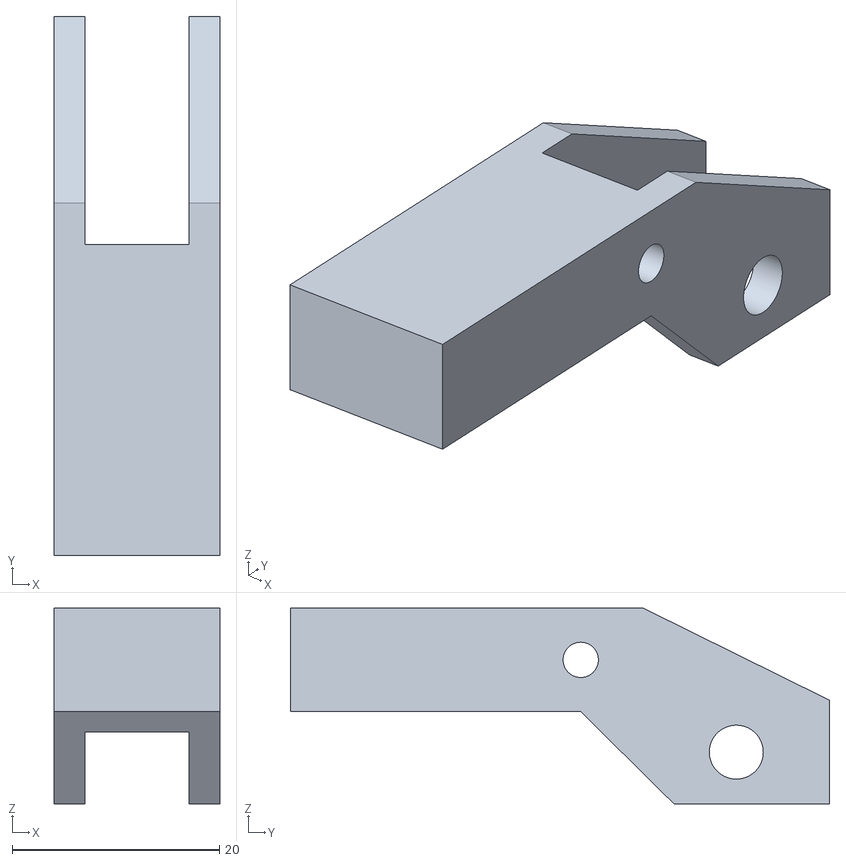
[picture p42: CAD file, 2026-10-31]
docs/stl/presion_brazo.stl
16.0 x 52.0 x 18.9
