worktechlabs/OpenPrinter/docs/stl/presion_soporte.stl

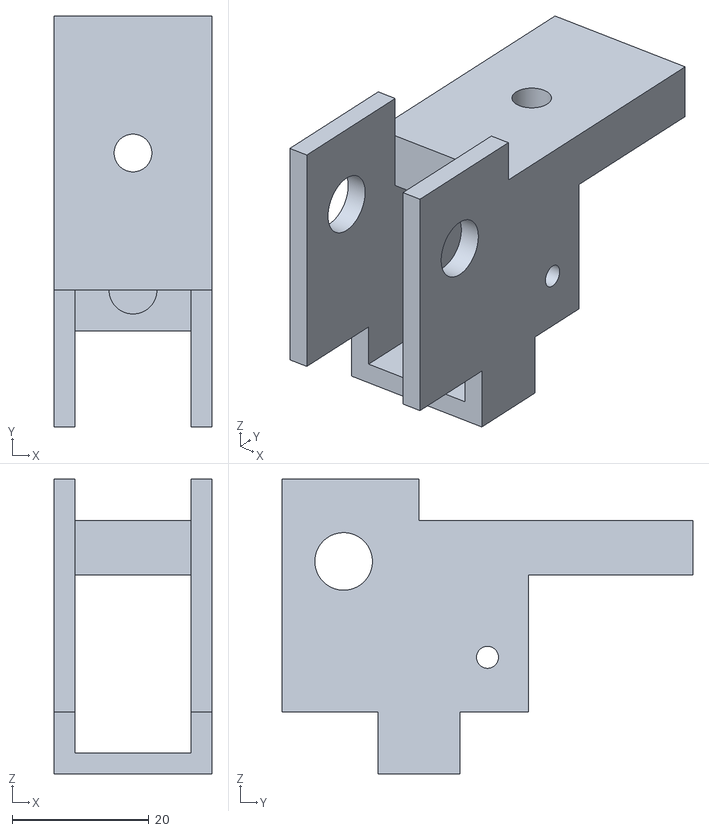
[picture p43: CAD file, 2026-10-31]
docs/stl/presion_soporte.stl
23.0 x 60.0 x 43.0
