worktechlabs/OpenPrinter/docs/stl/mesa_entrada_segmento.stl

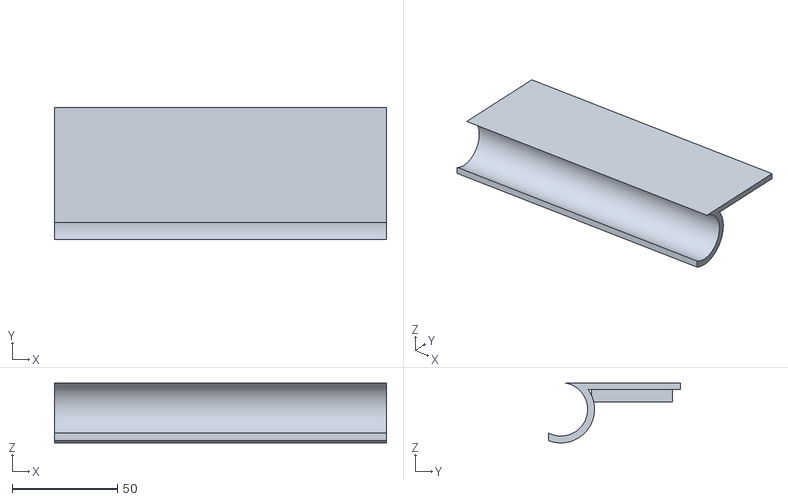
[picture p44: CAD file, 2026-10-31]
docs/stl/mesa_entrada_segmento.stl
158.0 x 63.0 x 28.5
