worktechlabs/OpenPrinter/docs/stl/electronica_caja.stl

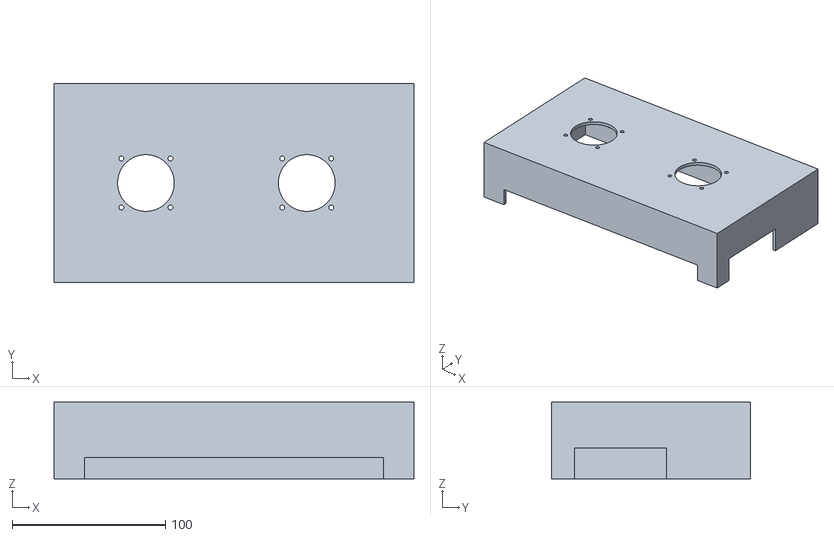
[picture p45: CAD file, 2026-10-31]
docs/stl/electronica_caja.stl
235.0 x 130.0 x 50.0
