worktechlabs/OpenPrinter/docs/stl/pantalla_soporte.stl

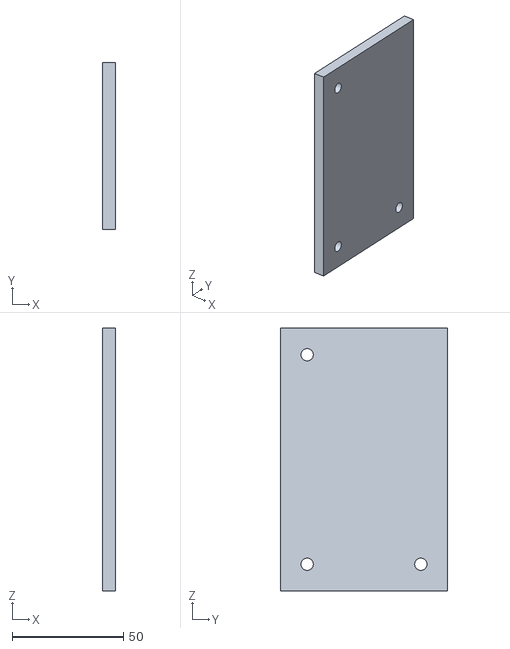
[picture p46: CAD file, 2026-10-31]
docs/stl/pantalla_soporte.stl
6.00 x 75.0 x 118.0
