worktechlabs/OpenPrinter/docs/stl/final_x_soporte.stl

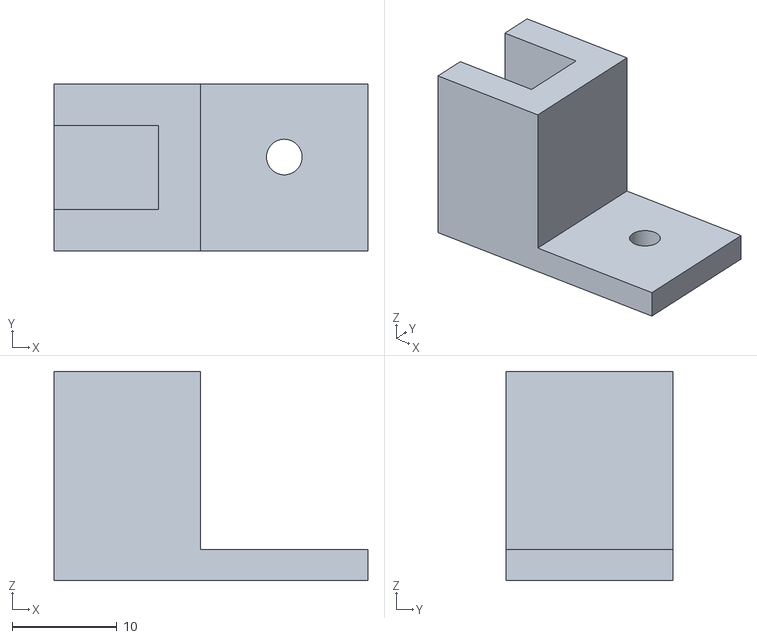
[picture p47: CAD file, 2026-10-31]
docs/stl/final_x_soporte.stl
30.0 x 16.0 x 20.0
