worktechlabs/OpenPrinter/docs/stl/carro_bandeja.stl

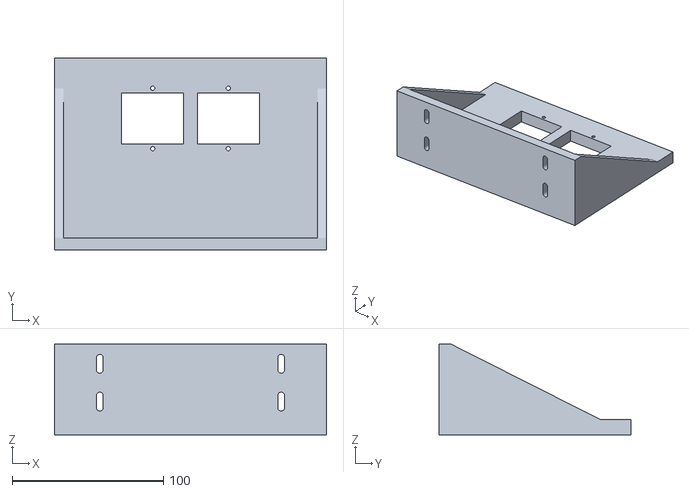
[picture p48: CAD file, 2026-10-31]
docs/stl/carro_bandeja.stl
180.0 x 127.0 x 60.0
