worktechlabs/OpenPrinter/docs/stl/tinta_soporte_bombas.stl

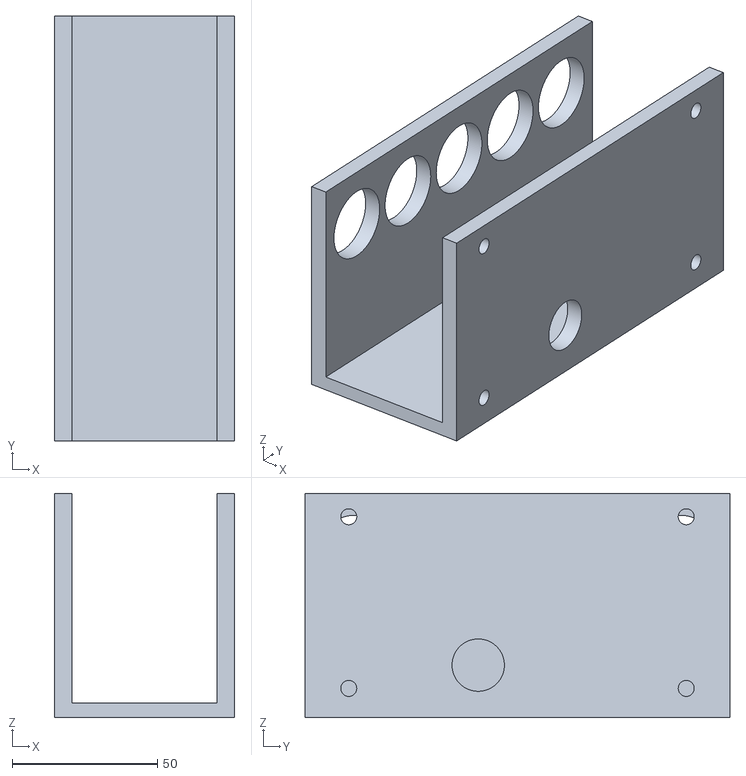
[picture p49: CAD file, 2026-10-31]
docs/stl/tinta_soporte_bombas.stl
62.0 x 146.0 x 77.0
