worktechlabs/OpenPrinter/docs/stl/encoder_soporte_sensor.stl

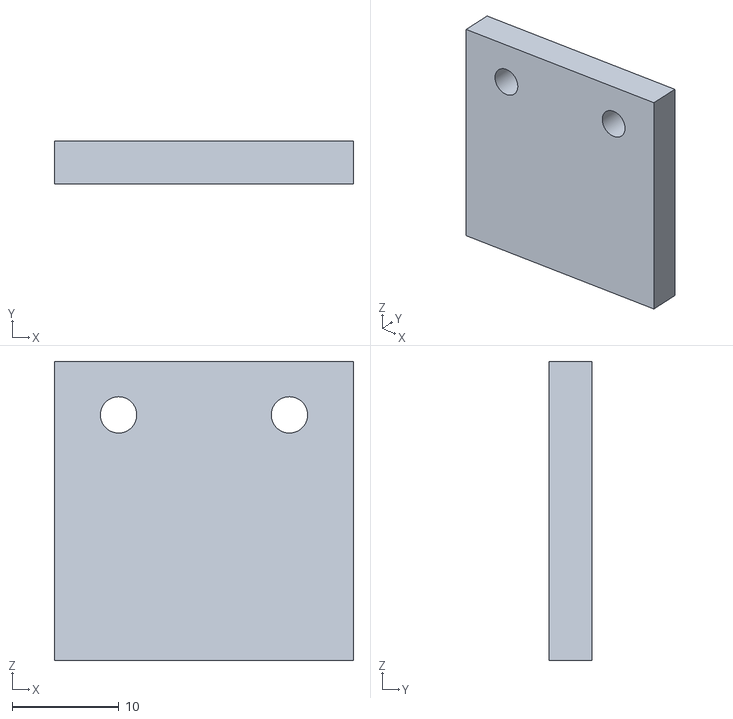
[picture p50: CAD file, 2026-10-31]
docs/stl/encoder_soporte_sensor.stl
28.0 x 4.00 x 28.0
