worktechlabs/OpenPrinter/docs/stl/encoder_soporte_cinta_izq.stl

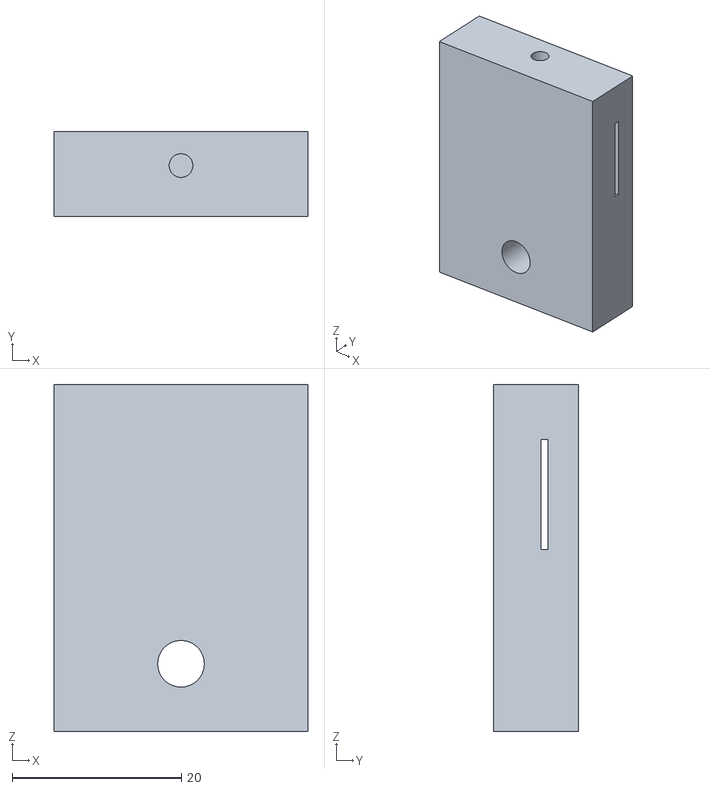
[picture p52: CAD file, 2026-10-31]
docs/stl/encoder_soporte_cinta_izq.stl
30.0 x 10.0 x 41.0
