worktechlabs/OpenPrinter/docs/stl/presion_palanca.stl

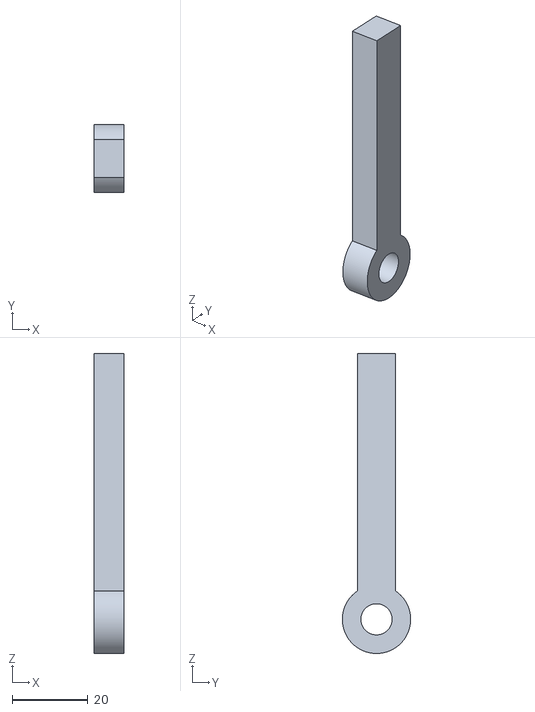
[picture p53: CAD file, 2026-10-31]
docs/stl/presion_palanca.stl
8.00 x 18.0 x 79.0
