worktechlabs/OpenPrinter/docs/stl/soporte_motor_x.stl

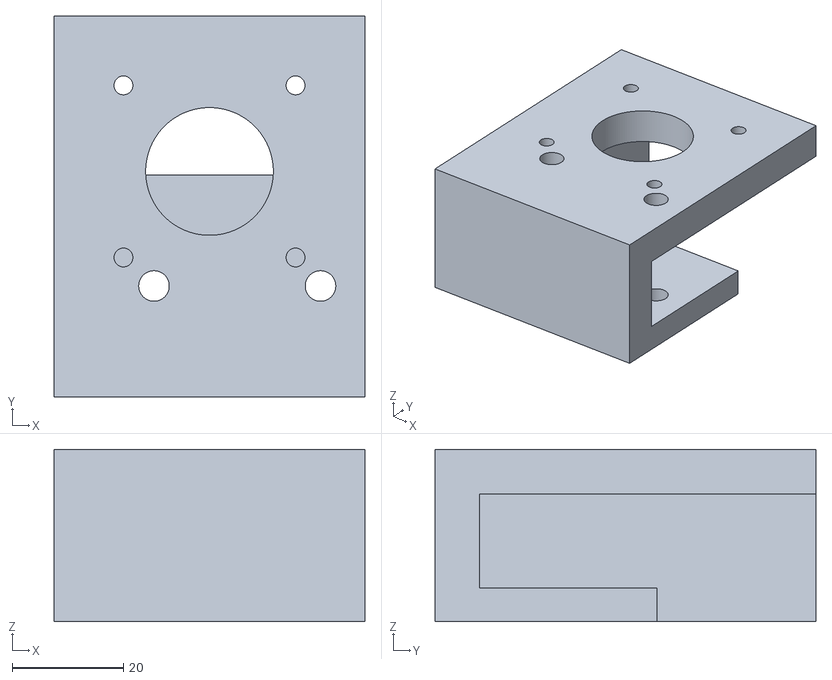
[picture p54: CAD file, 2026-10-31]
docs/stl/soporte_motor_x.stl
56.0 x 68.6 x 31.0
