worktechlabs/OpenPrinter/docs/stl/pantalla_carcasa.stl

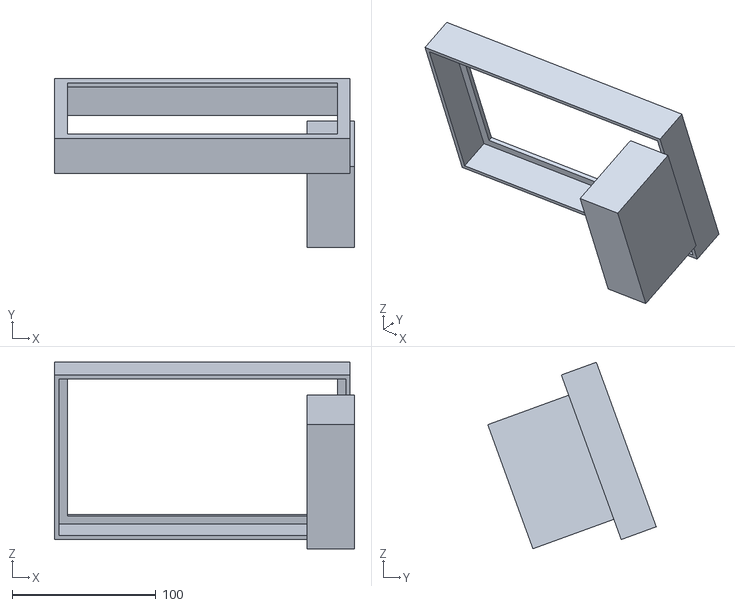
[picture p55: CAD file, 2026-10-31]
docs/stl/pantalla_carcasa.stl
209.0 x 117.4 x 130.0
