worktechlabs/OpenPrinter/docs/stl/final_x_bandera.stl

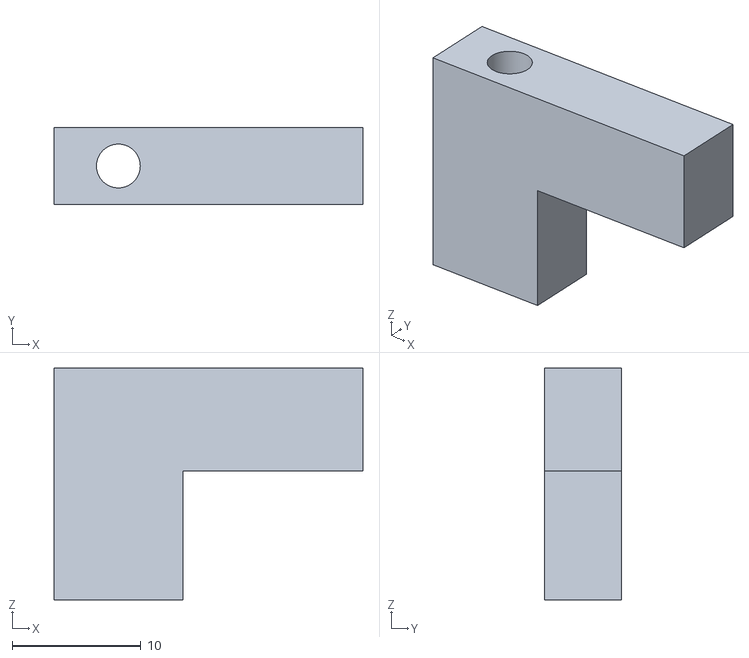
[picture p56: CAD file, 2026-10-31]
docs/stl/final_x_bandera.stl
24.0 x 6.00 x 18.0
