worktechlabs/OpenPrinter/docs/stl/tinta_soporte_subdepositos.stl

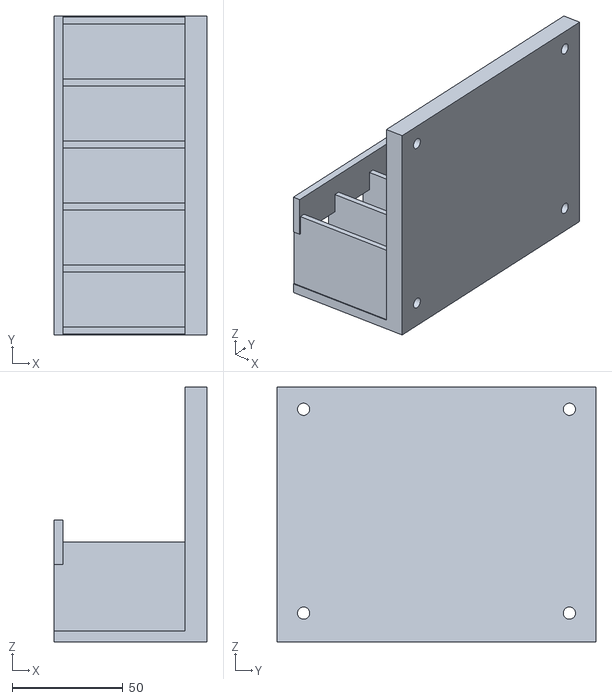
[picture p57: CAD file, 2026-10-31]
docs/stl/tinta_soporte_subdepositos.stl
69.0 x 144.0 x 115.0
