worktechlabs/OpenPrinter/docs/stl/tinta_caja_driver.stl

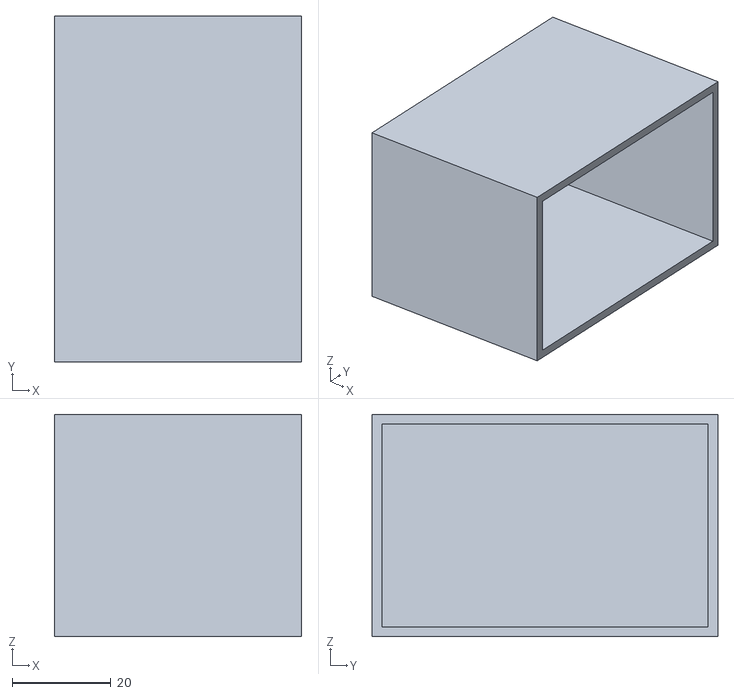
[picture p59: CAD file, 2026-10-31]
docs/stl/tinta_caja_driver.stl
50.0 x 70.0 x 45.0
