worktechlabs/OpenPrinter/docs/stl/tinta_clip_tubos.stl

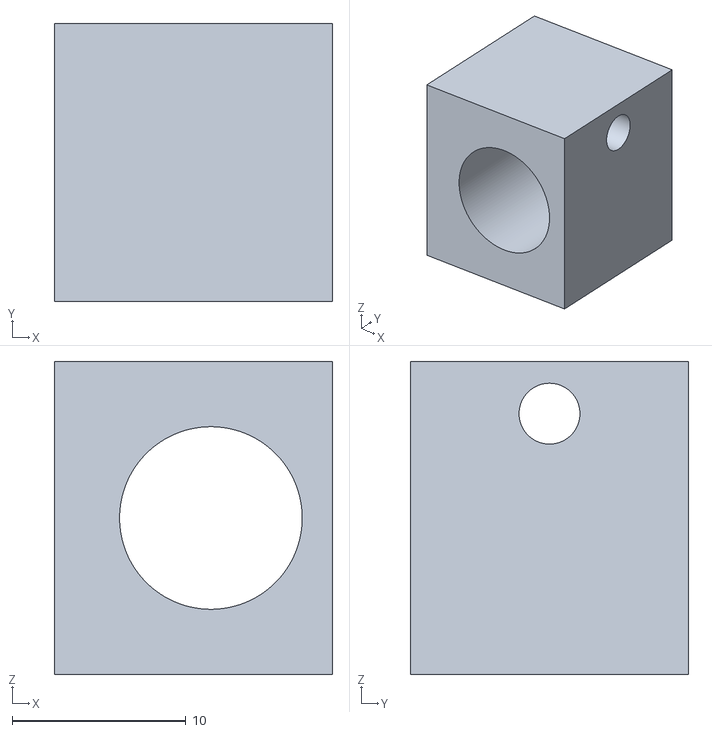
[picture p60: CAD file, 2026-10-31]
docs/stl/tinta_clip_tubos.stl
16.0 x 16.0 x 18.0
