worktechlabs/OpenPrinter/docs/stl/canaleta_tramo_200.stl

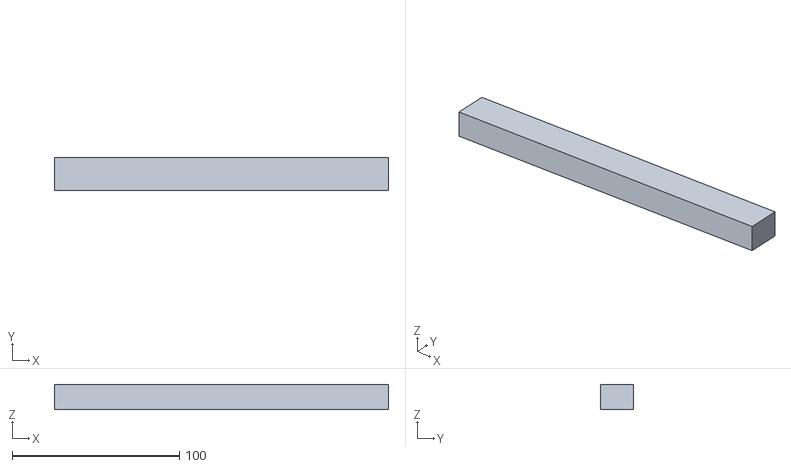
[picture p61: CAD file, 2026-10-31]
docs/stl/canaleta_tramo_200.stl
200.0 x 20.0 x 15.0
