worktechlabs/OpenPrinter/docs/stl/cadena_bandeja.stl

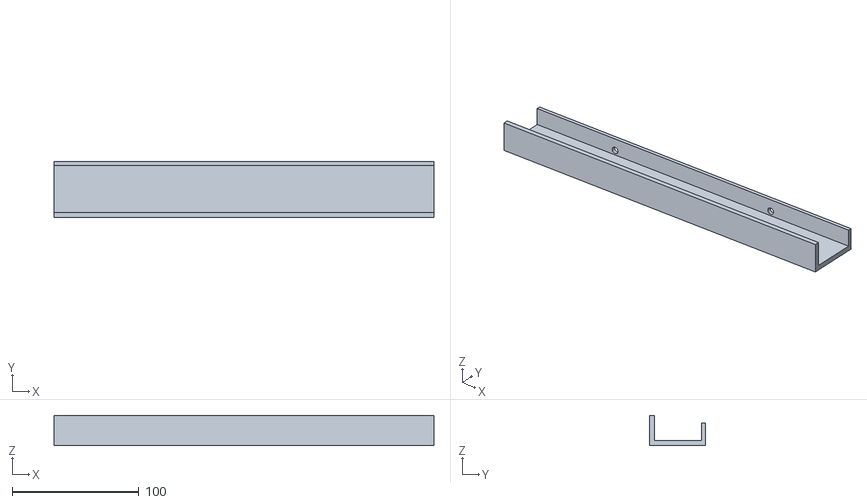
[picture p62: CAD file, 2026-10-31]
docs/stl/cadena_bandeja.stl
300.0 x 44.0 x 24.0
