worktechlabs/OpenPrinter/docs/stl/encoder_y_soporte.stl

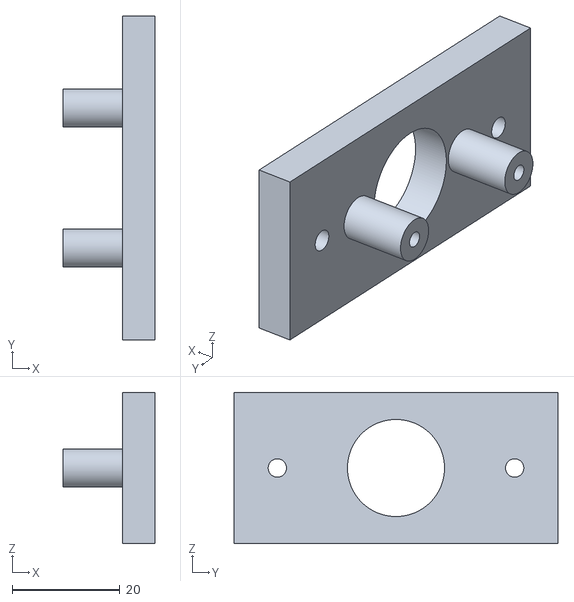
[picture p63: CAD file, 2026-10-31]
docs/stl/encoder_y_soporte.stl
17.0 x 60.0 x 28.0
