worktechlabs/OpenPrinter/docs/stl/mesa_camara.stl

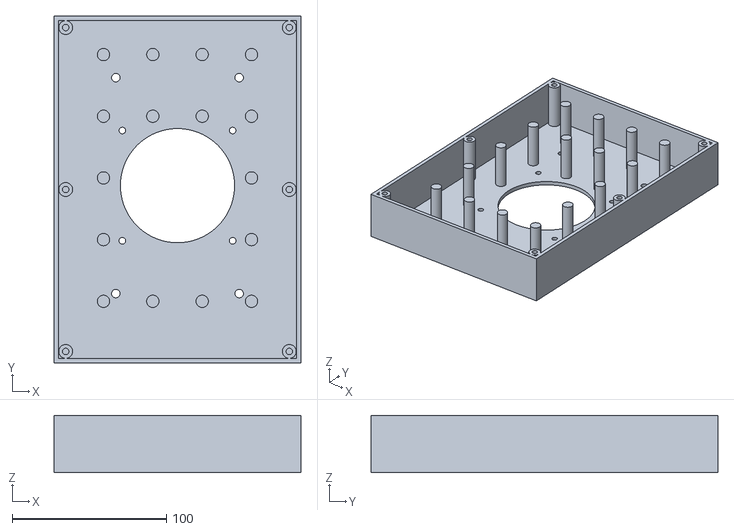
[picture p64: CAD file, 2026-10-31]
docs/stl/mesa_camara.stl
160.0 x 225.0 x 37.0
