worktechlabs/OpenPrinter/docs/stl/soporte_motor_y.stl

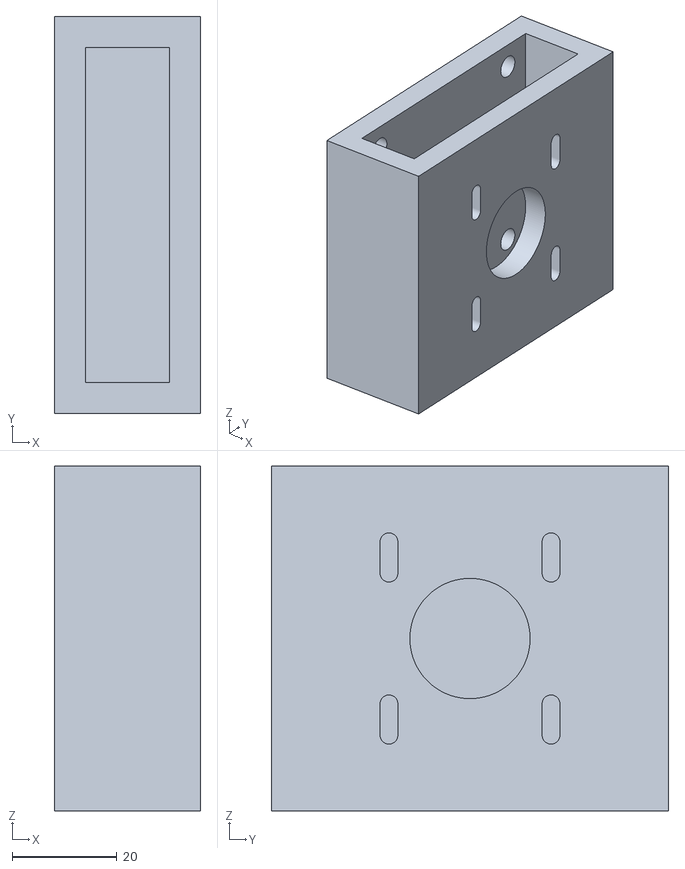
[picture p65: CAD file, 2026-10-31]
docs/stl/soporte_motor_y.stl
28.0 x 76.0 x 66.0
