worktechlabs/OpenPrinter/docs/stl/rollo_collarin.stl

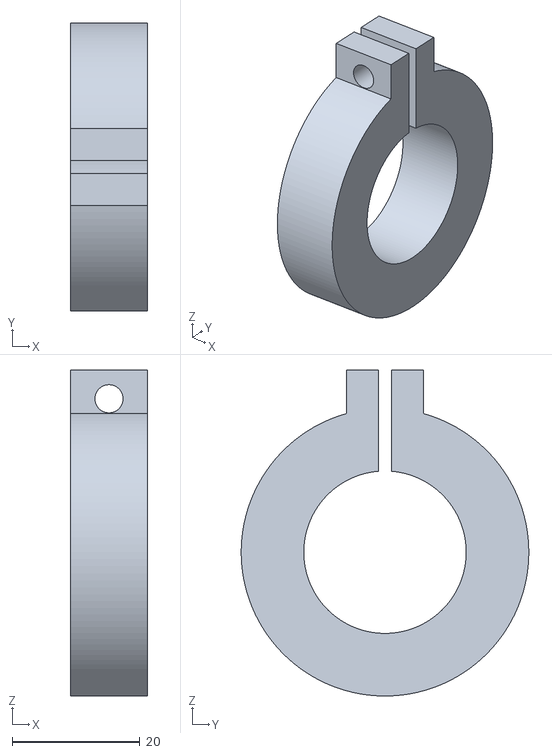
[picture p66: CAD file, 2026-10-31]
docs/stl/rollo_collarin.stl
12.0 x 45.0 x 51.0
