worktechlabs/OpenPrinter/docs/stl/electronica_brida_fuente.stl

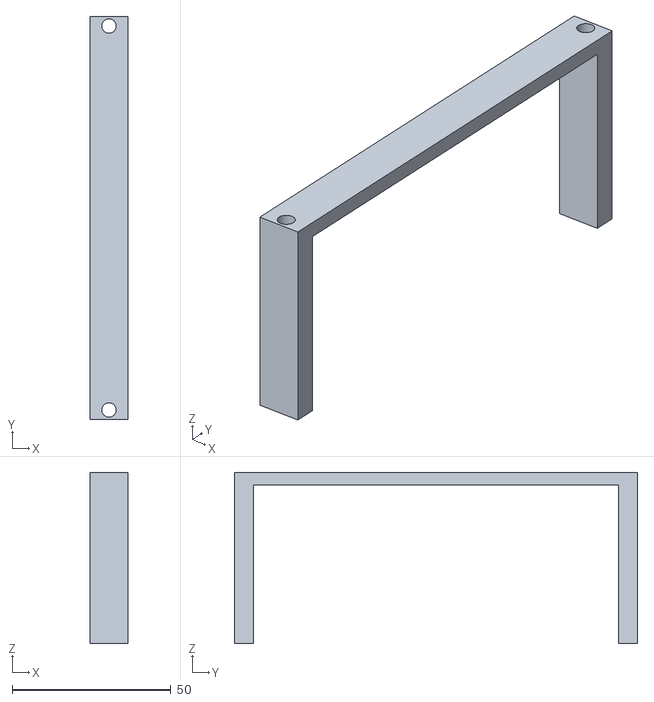
[picture p67: CAD file, 2026-10-31]
docs/stl/electronica_brida_fuente.stl
12.0 x 127.0 x 54.0
