worktechlabs/OpenPrinter/docs/stl/encoder_soporte_cinta_der.stl

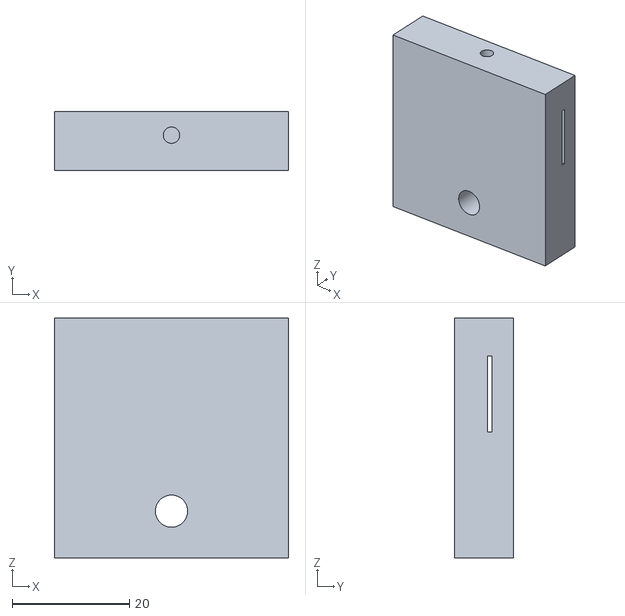
[picture p68: CAD file, 2026-10-31]
docs/stl/encoder_soporte_cinta_der.stl
40.0 x 10.0 x 41.0
