worktechlabs/OpenPrinter/docs/stl/soporte_tensor_x.stl

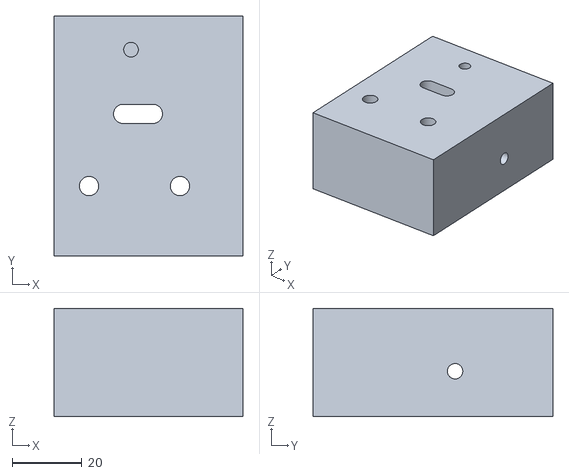
[picture p69: CAD file, 2026-10-31]
docs/stl/soporte_tensor_x.stl
54.0 x 68.6 x 31.0
