worktechlabs/OpenPrinter/docs/stl/servicio_base.stl

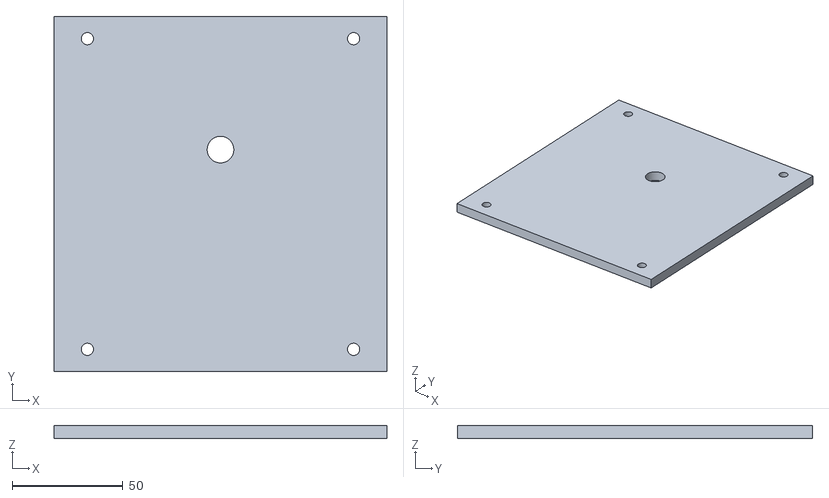
[picture p70: CAD file, 2026-10-31]
docs/stl/servicio_base.stl
150.0 x 160.0 x 6.00
