worktechlabs/OpenPrinter/docs/stl/tinta_base_botellas.stl

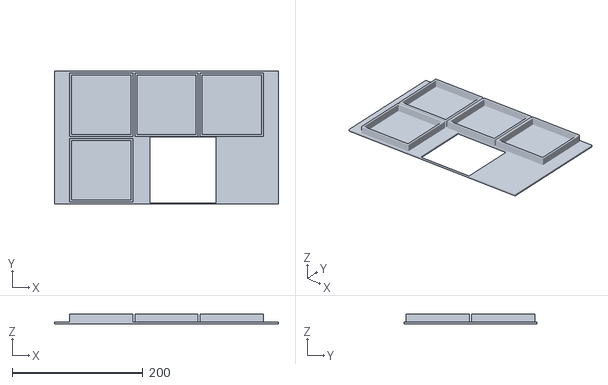
[picture p71: CAD file, 2026-10-31]
docs/stl/tinta_base_botellas.stl
343.0 x 203.0 x 15.0
