worktechlabs/OpenPrinter/docs/montaje.html

OpenPrinter Montaje interactivo ← Volver a la web

Cargando el modelo 3D…

Ver todo Atenuar anteriores ▶ Animar Encuadrar

← AnteriorSiguiente →

## Piezas de este paso

## Buscar cualquier pieza

Arrastra para girar, rueda o pellizca para acercar y botón derecho para desplazar. Las piezas con STL se imprimen: pulsa para descargarlas. Guía en texto: montaje.md.
