worktechlabs/OpenPrinter/(commit log)

2026-10-31 Diseño fase 0 (0.1-0.4), README con alcance y licencia CERN-OHL-S para hardware
    - Plan de diseño y esqueleto de distribución paramétrico (CadQuery)
    - Chasis: placas laterales con DXF, bastidor 4040 y lista de corte
    - Viga X: guías MGN12, soportes de motor y tensor impresos, correa GT2
    - Carro impreso con bandeja de cabezales y ajuste de altura
    - README con alcance, hoja de ruta, seguridad y licencias
2026-10-31 Fases 0.5-0.6: mesa de vacío por zonas y arrastre Y con presión y levante
    - Mesa: placa de aluminio perforada (DXF) sobre 4 cámaras impresas con ventilador
    - Arrastre: rodillo en rodamientos 6001, 6 unidades de presión impresas,
    eje de levante con levas excéntricas y motor Y con reducción 4:1
    - Placas laterales: agujeros para eje de levante y soporte del motor Y
2026-10-31 Fases 0.7-0.8: rollos con mandriles y freno, guías, mesa de entrada y base de servicio
    - Ejes fijos de Ø25 en las ranuras de las placas, mandriles impresos con 6005
    - Collarines de posición/freno y retención exterior
    - Guía delantera nueva (agujeros M6 en placas) y mesa de entrada a presión
    - Estación de servicio: base sobre los travesaños y volúmenes reservados
    - Lista de piezas impresas de la fase 0
2026-10-31 Lista de compra, renders de presentación y web con visor 3D
    - cad/bom.py: lista de compra de la fase 0 calculada desde el modelo (MD y CSV)
    - cad/render_pv.py: renders con PyVista en docs/img
    - cad/web.py: GLB de presentación en docs/model
    - docs/index.html: web para GitHub Pages con visor 3D, módulos y lista de compra
    - README con imágenes, enlaces a la web y a la lista de compra
    [compra_fase0.csv]
2026-10-31 README: enlazar el modelo 3D en lugar de la web de GitHub Pages
2026-10-31 Fase 1: arquitectura de movimiento, sensores, cadena, electrónica y reserva de tinta
    - docs/fase1_movimiento.md: Klipper para el movimiento y encoder X como referencia
    del disparo; reutiliza placas, Raspberry Pi y motores de impresora 3D
    - cad/motion.py: cinta y sensor del encoder X, final de carrera X, encoder Y
    AS5047P, cadena portacables con bandeja y brazo, placa de electrónica
    - Rack de tanques de tinta reservado por fuera de la placa izquierda
    - Listas de compra de fases 0 y 1, renders y modelo web actualizados
    [compra_fase0.csv, compra_fase1.csv]
2026-10-31 Placas laterales en MDF de 19 mm con plantillas A4 a tamaño real
    - SIDE_PLATE_MATERIAL: MDF (low cost) o aluminio; rodamiento del rodillo en
    alojamiento impreso por la cara interior cuando es MDF
    - cad/plantillas.py: PDF con portada, tabla de taladros y hojas A4 1:1 con
    cuadrícula de empalme y regla de comprobación
    - Listas de compra, README y PLAN actualizados; tanques de tinta en
    compartimento cerrado
    [compra_fase0.csv, compra_fase1.csv]
2026-10-31 Lista de compra en Amazon UK y cadena portacables con radio comercial R18
2026-10-31 Inventario disponible: SKR Mini E3 V3, motores 42-40 y fuente 24 V reutilizados
    - docs/inventario.md con el material del taller y su uso
    - Fase 1: señales asignadas a la SKR Mini E3 V3.0, encoder Y al Pico,
    cálculo de par con NEMA17 de 40 mm
    - Listas de compra sin la fuente, la placa ni los motores
    [compra_fase1.csv]
2026-10-31 Decisión: guías MGN12 sobre perfil serie 40 cortado a medida
    - Compra UK: patines extra MGN12H y proveedores de perfil a medida
    - V-slot 2020 del inventario reservado para el compartimento de tinta y la cubierta
2026-10-31 Compartimento de tinta, electrónica con fuente, paneles y canaletas; compra UK y web
    - cad/ink.py: compartimento cerrado con marco V-slot 2020, depósitos C M Y K y
    blanco sobre agitador, paneles de MDF y metacrilato, tubos con clips
    - cad/wiring.py: bandeja inferior de lado a lado, caja impresa con SKR, Pi,
    Pico y convertidores, fuente con bridas, paneles IEC y de emergencia y
    canaletas hasta la cadena, motor Y y encoder Y
    - Perfil serie 20 en lib.profile; cinta de encoder de 12 mm; bandeja de la
    cadena hasta la placa izquierda
    - docs/compra_uk.md con opciones de Amazon UK, eBay UK y AliExpress
    - Web con secciones de tinta, electrónica y lista de compra por fases;
    renders y READ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
    [compra_fase1.csv]
2026-10-31 Web: quitar la versión antigua duplicada de la página
2026-10-31 Render de la caja de electrónica más cercano
2026-10-31 Tinta a granel con bombas, salida sin recogida, pantalla y montaje interactivo
    - Tinta: botellas de 1 L en una caja comprada sobre una repisa detrás a la
    derecha; bombas peristálticas y subdepósitos con flotador por fuera de la
    placa izquierda; tubos hasta la cadena portacables.
    - Film: sin rollo de recogida; rampa de salida impresa en la guía delantera.
    - Pantalla táctil de 7" con carcasa y pletina en la esquina delantera derecha.
    - Montaje: 10 pasos (cad/montaje.py), esquemas por paso, docs/montaje.md y
    visor 3D interactivo docs/montaje.html con STL de cada pieza en docs/stl.
    - STL de la máquina completa y del sistema de tinta.
    - Incluye el análisis de cabezales (docs/cabezale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
    [cadena_bandeja.stl, cadena_brazo.stl, canaleta_tramo_200.stl, carro_bandeja.stl, carro_pinza_correa.stl, carro_placa.stl, compra_fase0.csv, compra_fase1.csv]
2026-10-31 Montaje interactivo: más distancia de cámara en pantallas estrechas
2026-10-31 Firmware de la fase 1: configuración de Klipper, tinta y KlipperScreen
    - printer.cfg: SKR Mini E3 V3.0, X con home en la estación de servicio, Y de
    film sin final, Z ficticio, vacío en dos grupos, sensor de film, palanca y
    la Raspberry Pi como segunda MCU.
    - tinta.cfg: bombas y flotadores en GPIO; relleno automático con tiempo
    máximo y aviso de botella vacía.
    - macros.cfg: vacío, carro, film, inicio y fin de trabajo, pausa y pruebas.
    - KlipperScreen.conf: menú OpenPrinter para la pantalla táctil.
    - Guía de instalación, cableado y primer arranque.
    [compra_fase1.csv, macros.cfg, printer.cfg, tinta.cfg]
2026-10-31 Cabezal XP600: dónde comprarlo y cuándo
    - compra_uk.md: cabezal XP600 original (UE) y alternativa en Reino Unido,
    cables de datos, y comprarlo con la máquina montada y la placa elegida.
    - cabezales.md: precios actualizados.
2026-10-31 Monitor de encoders en el Pico y registro de las pruebas de la fase 1
    - pico_encoder/main.py (MicroPython): encoder X contado por el PIO (x2, una
    sola resta por flanco para que las lecturas no se corrompan), AS5047P por
    SPI con comprobación de paridad y suma de vueltas, salida CSV por USB y
    órdenes para cero, frecuencia y pausa.
    - pico_encoder/registro.py (Raspberry Pi): guarda en mm y analiza la prueba
    de pasadas (rizado de velocidad e inversiones) y la de avance (error frente
    a lo ordenado y corrección de rotation_distance).
    - Conexiones, divisor para sensores de 5 V e instrucciones en firmware/README.md.
    [compra_fase1.csv]
2026-11-03 Renombra el proyecto a OpenDTF
    Evita la confusión con Open Printer, de Open Tools. El modelo pasa a
    docs/model/opendtf.glb y opendtf_completo.stl, y el menú de KlipperScreen
    a "OpenDTF".
    [macros.cfg, opendtf_completo.stl, printer.cfg, tinta.cfg]
